IowaScaledEngineering/ckt-bd1/doc/ckt-bd1-bag-top.odt

Iowa Scaled Engineering, LLC

http://iascaled.com/

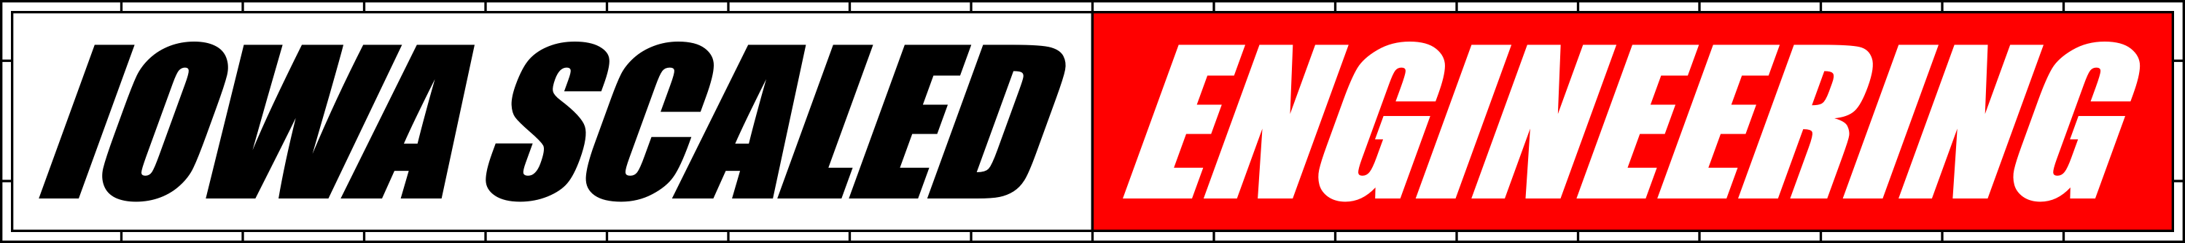
[picture p1: figure]

DCC Block Detector

The CKT-BD1 is a single-channel DCC block detector designed for high reliability and easy installation, providing two open collector outputs, adjustable sensitivity, and isolation between the track and signal systems.

CKT-BD1
