IowaScaledEngineering/ckt-bd1/pg/ckt-bd1-v4eval-v1.0-783c78a/ckt-bd1-v4eval-pcb.pdf

# ckt-bd1-v4eval.pcb

# 1. Table of Contents (This Page) Created on Sun Aug 15 19:28:39 2021

# 2. top 3. bottom 4. outline 5. plated-drill 6. componentmask 7. soldermask 8. topsilk 9. bottomsilk 10. toppaste 11. topassembly 12. bottomassembly 13. fab

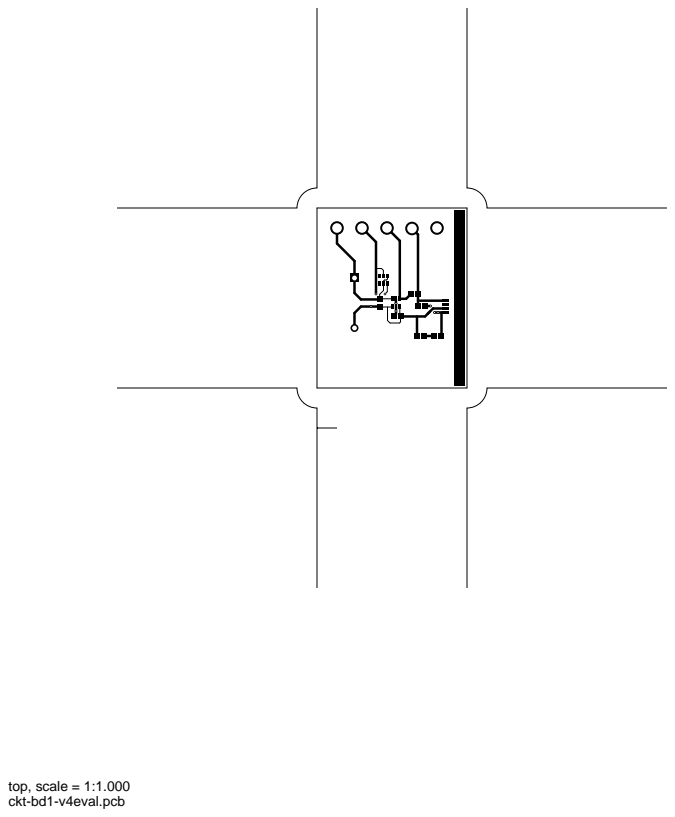
[picture p2: page 2]
top, scale = 1:1.000

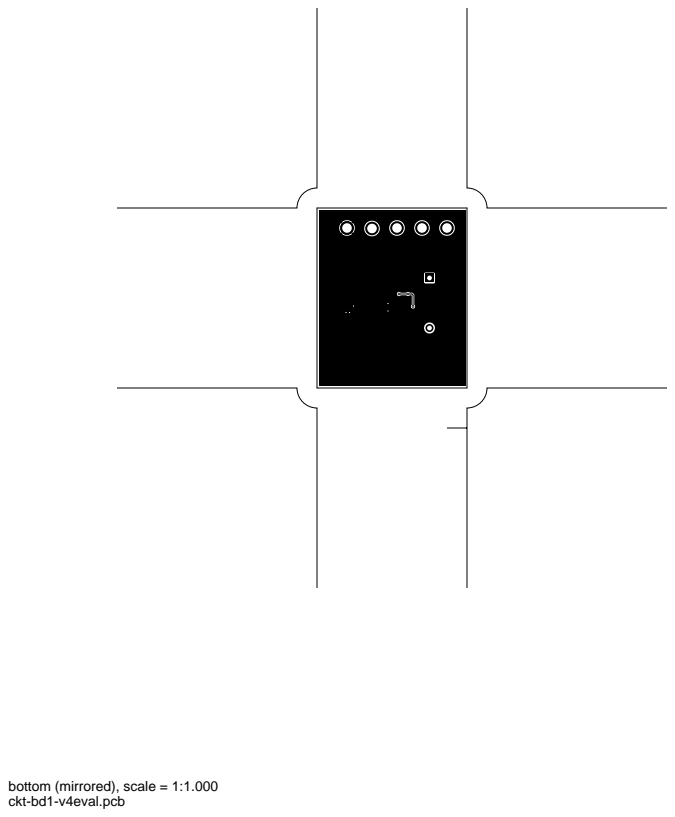
[picture p3: page 3]

bottom (mirrored), scale = 1:1.000

outline, scale = 1:1.000 plated-drill, scale = 1:1.000

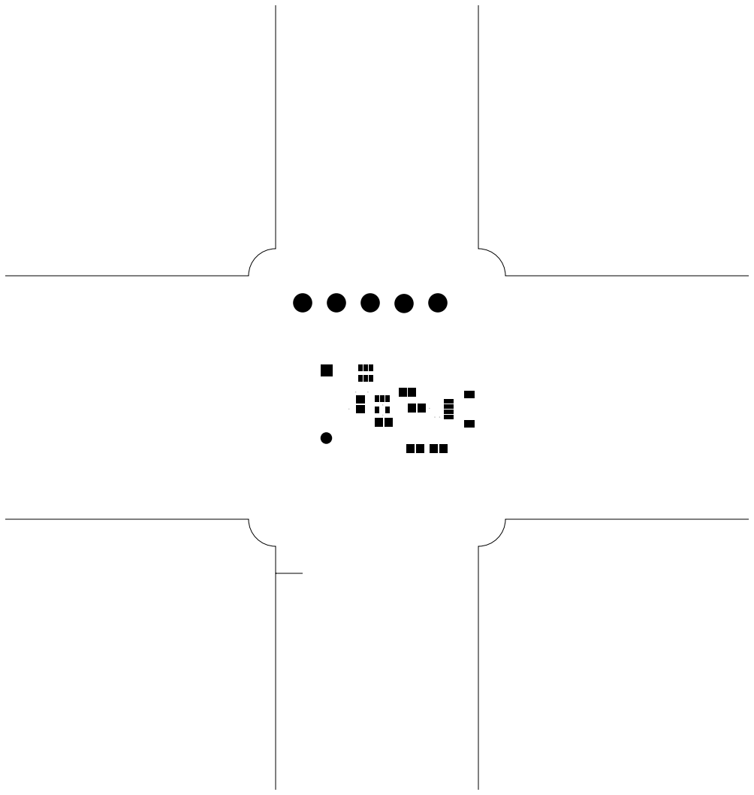
[picture p4: figure]

topmask, scale = 1:1.000

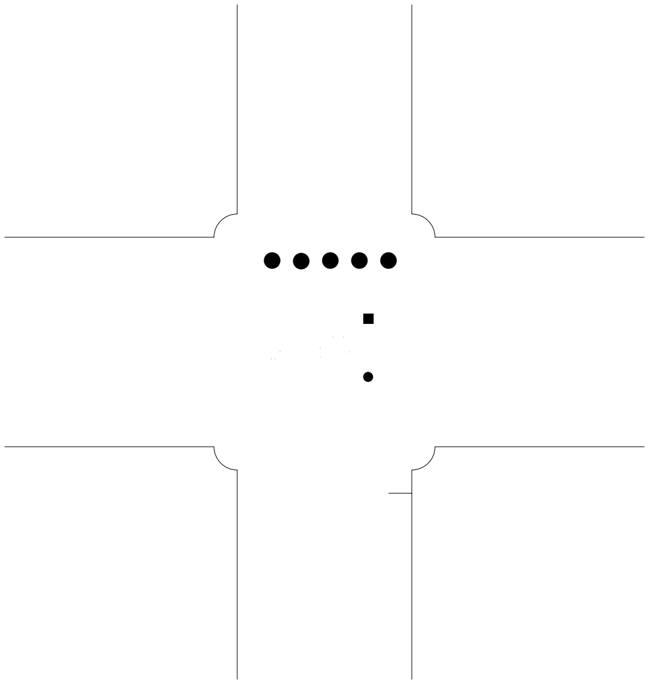
[picture p5: figure]

bottommask (mirrored), scale = 1:1.000

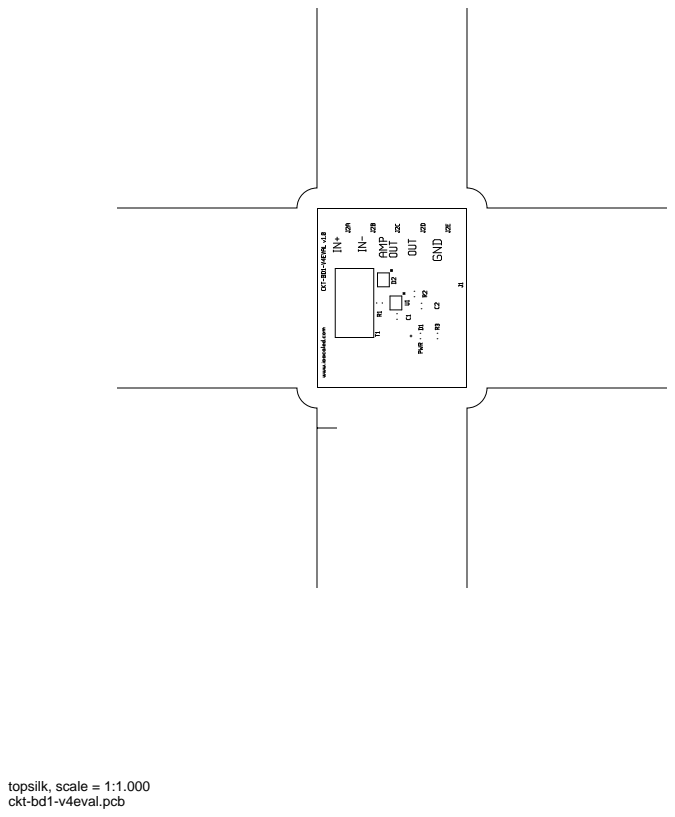
[picture p6: page 8]
topsilk, scale = 1:1.000

bottomsilk (mirrored), scale = 1:1.000

toppaste, scale = 1:1.000

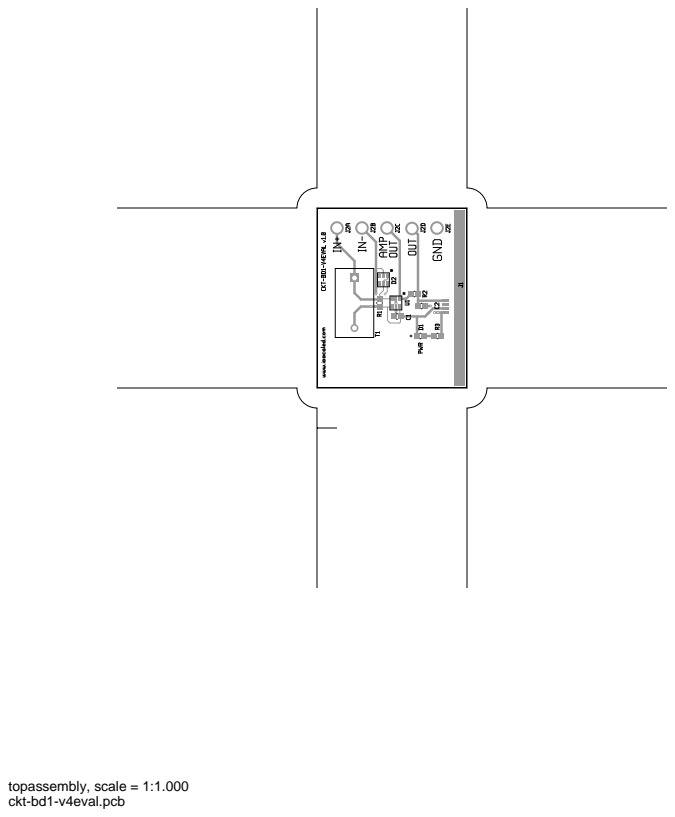
[picture p7: page 11]
topassembly, scale = 1:1.000

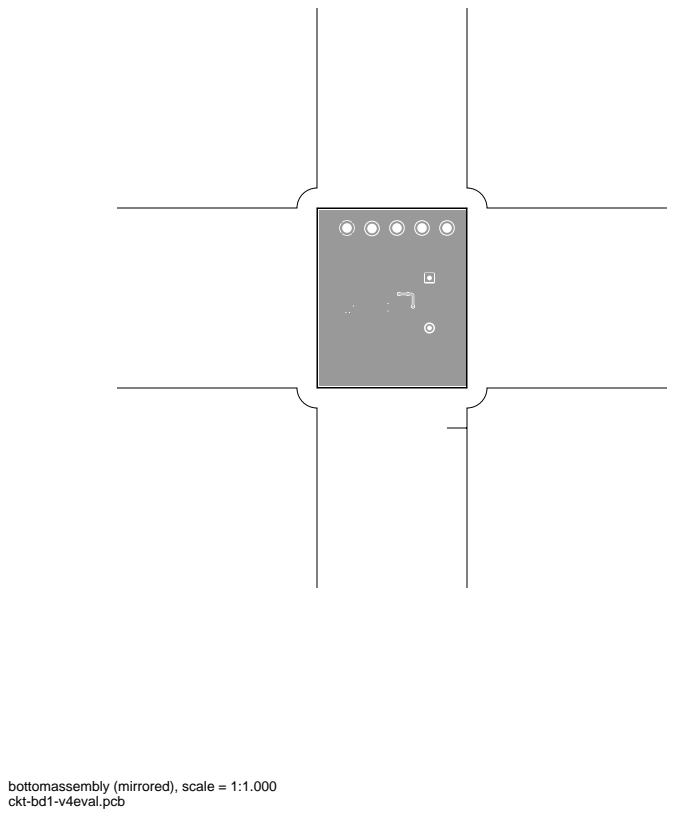
[picture p8: page 12]

bottomassembly (mirrored), scale = 1:1.000

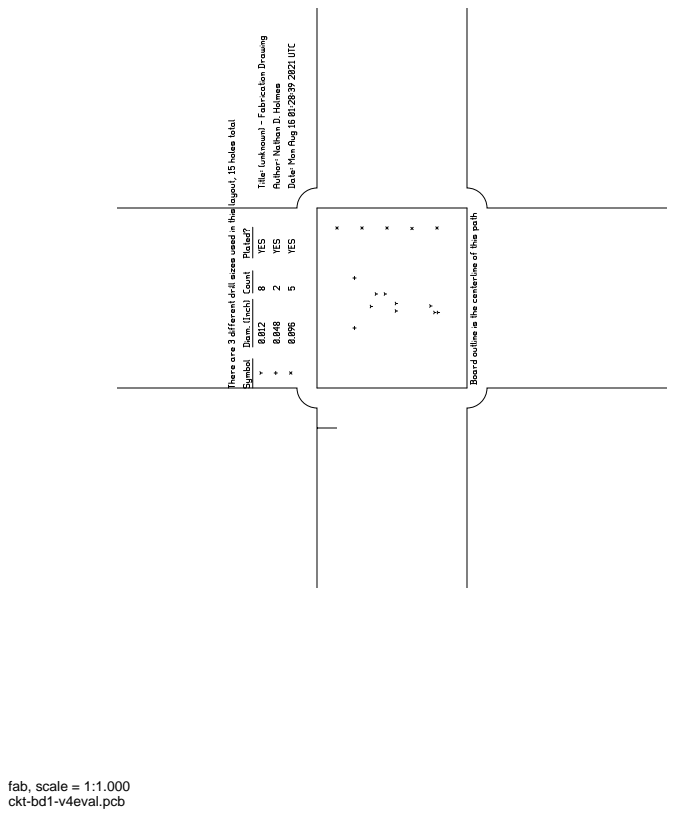
[picture p9: page 13]
fab, scale = 1:1.000
