IowaScaledEngineering/ckt-bd1/pg/ckt-bd1-cal-v1.0-e9a343d/ckt-bd1-cal-pcb.pdf

# ckt-bd1-cal.pcb

# 1. Table of Contents (This Page) Created on Thu Jul 2 14:46:42 2020

# 2. top 3. bottom 4. outline 5. bottommask 6. plated-drill 7. componentmask 8. soldermask 9. topsilk 10. bottomsilk 11. toppaste 12. topassembly 13. bottomassembly 14. fab

top, scale = 1:1.000

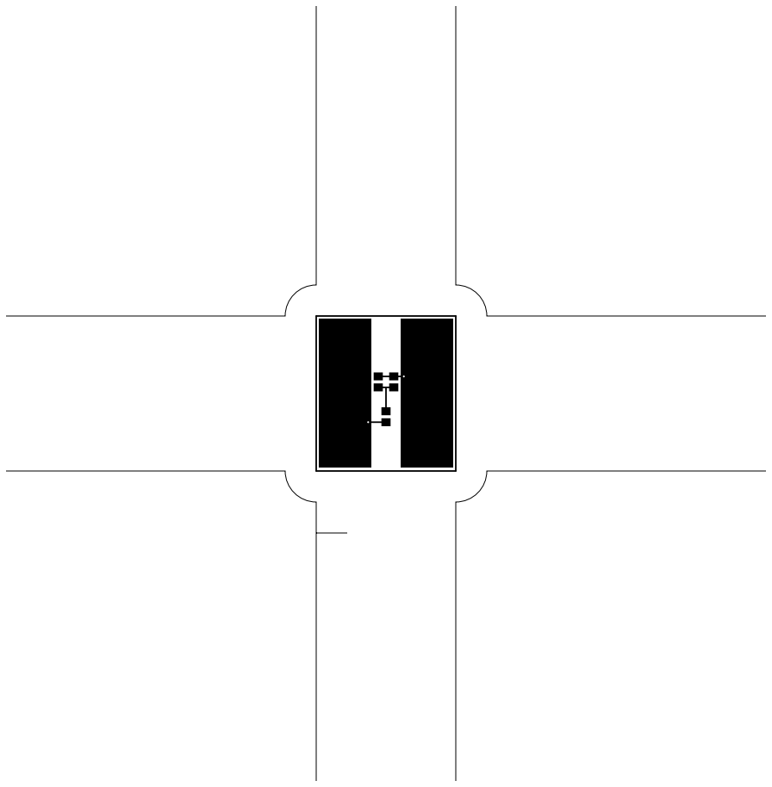
[picture p10: figure]

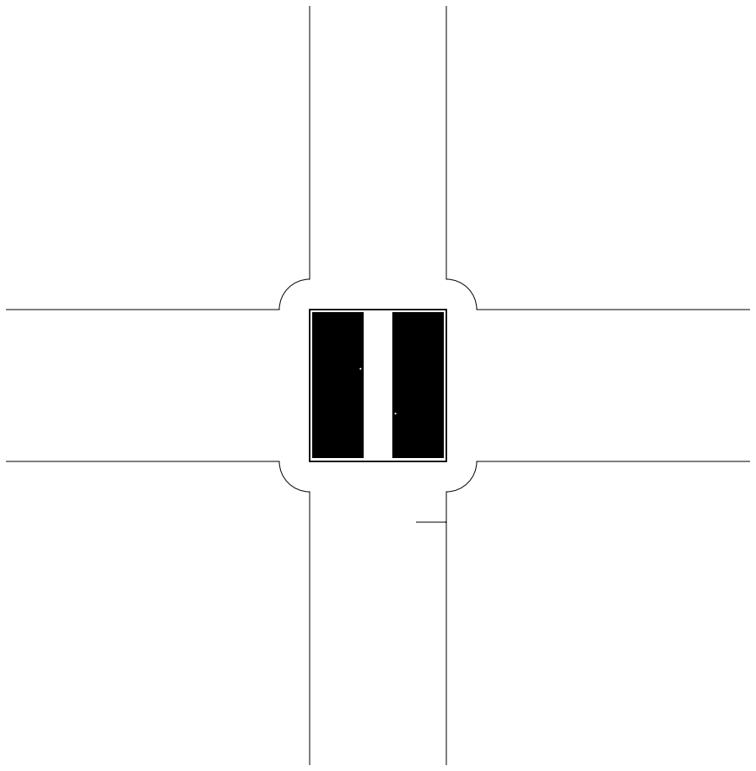
[picture p11: figure]

bottom (mirrored), scale = 1:1.000

outline, scale = 1:1.000

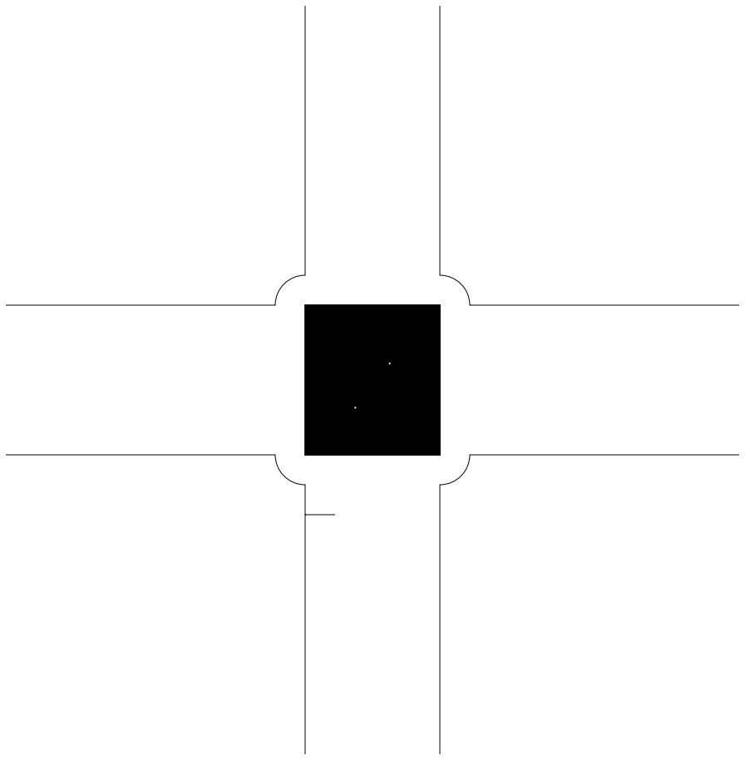
[picture p12: figure]

group3, scale = 1:1.000 plated-drill, scale = 1:1.000

topmask, scale = 1:1.000 bottommask (mirrored), scale = 1:1.000

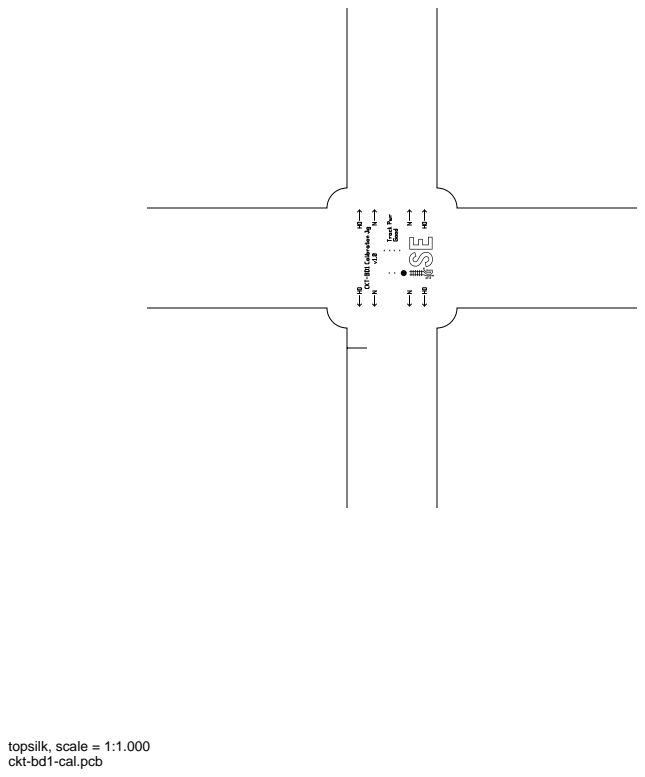
[picture p13: page 9]
topsilk, scale = 1:1.000

bottomsilk (mirrored), scale = 1:1.000

toppaste, scale = 1:1.000

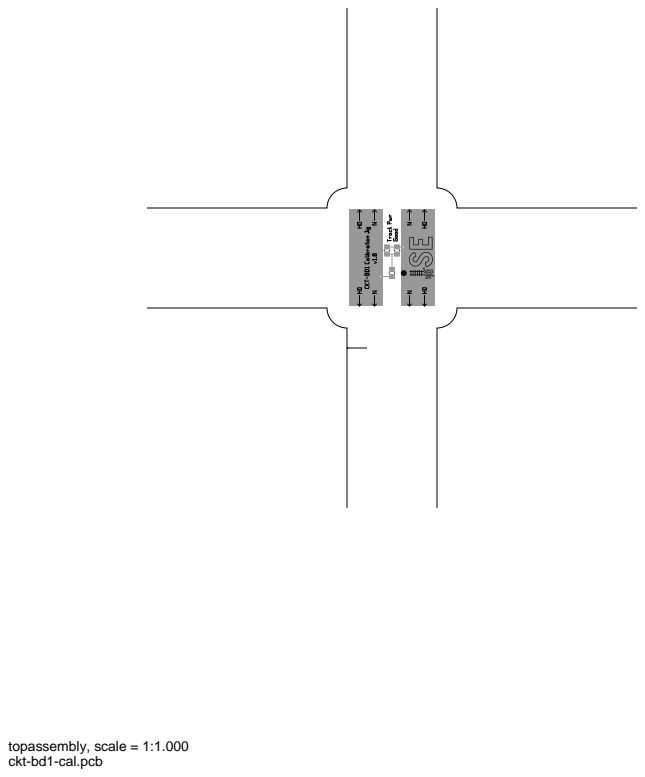
[picture p14: page 12]
topassembly, scale = 1:1.000

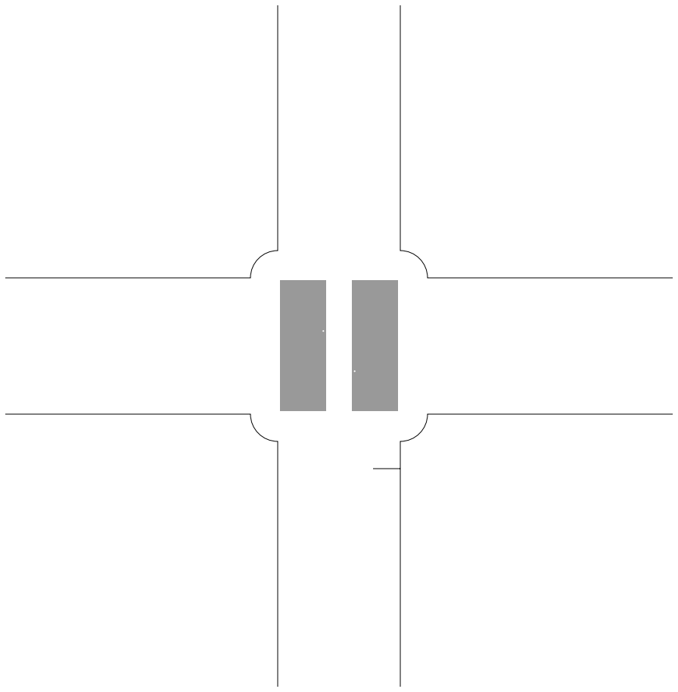
[picture p15: figure]

bottomassembly (mirrored), scale = 1:1.000

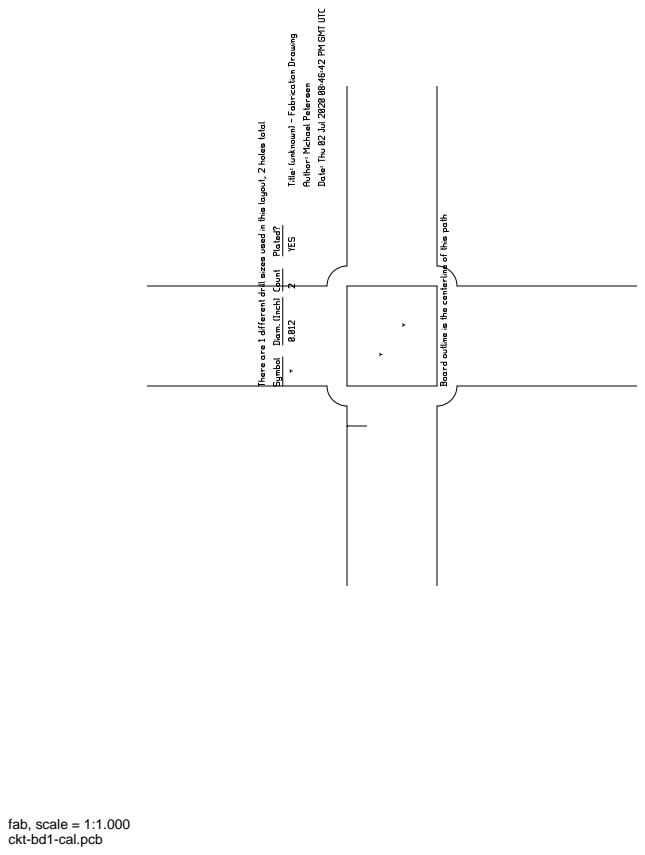
[picture p16: page 14]
fab, scale = 1:1.000
