IowaScaledEngineering/ckt-bd1/doc/ckt-bd1.png

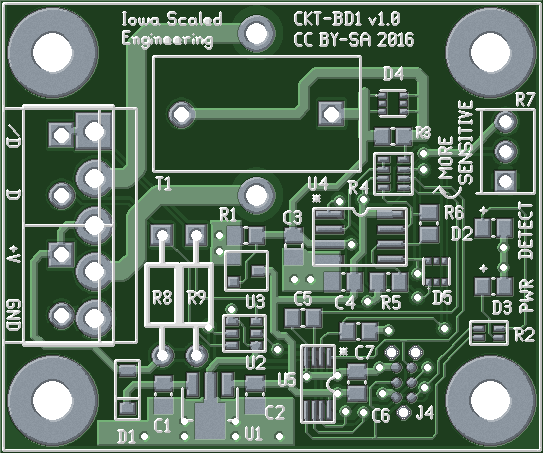
doc/ckt-bd1.png
