IowaScaledEngineering/ckt-bd1/mech/bd1-12x-blister-box v7.stl

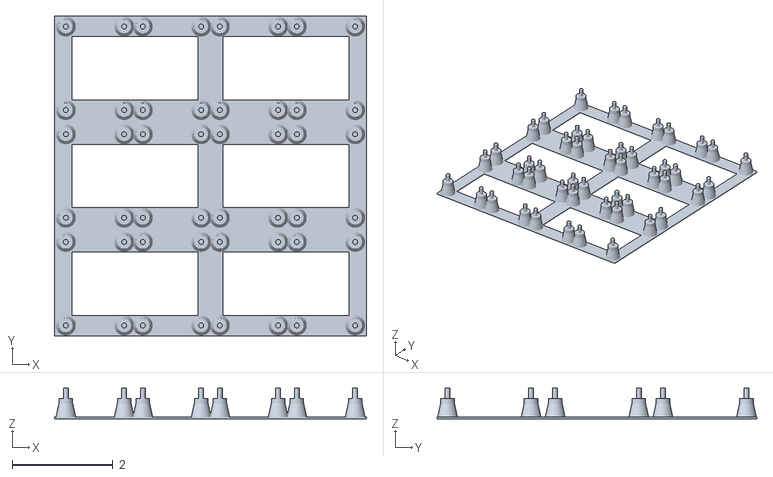
[picture p18: CAD file, 2023-02-24]
mech/bd1-12x-blister-box v7.stl
6.20 x 6.35 x 0.606
