IowaScaledEngineering/ckt-bd1/mech/bd1-6x-blister-box v5.stl

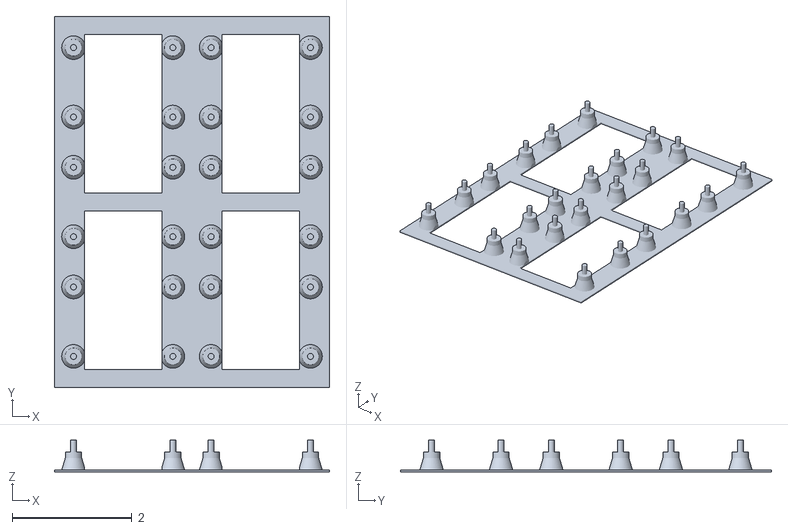
[picture p19: CAD file, 2023-02-24]
mech/bd1-6x-blister-box v5.stl
4.60 x 6.20 x 0.531
