IowaScaledEngineering/ckt-bd1/mech/bd1-blister-box v5.stl

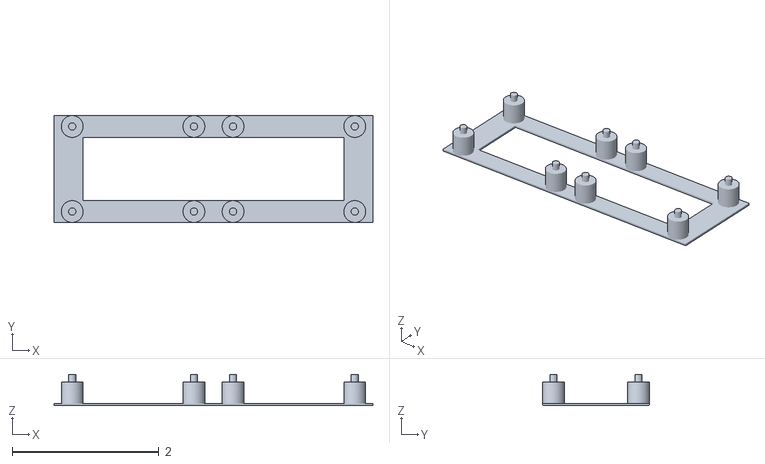
[picture p20: CAD file, 2022-12-14]
mech/bd1-blister-box v5.stl
4.35 x 1.46 x 0.425
