IowaScaledEngineering/ckt-bd1/doc/usermanual/render.png

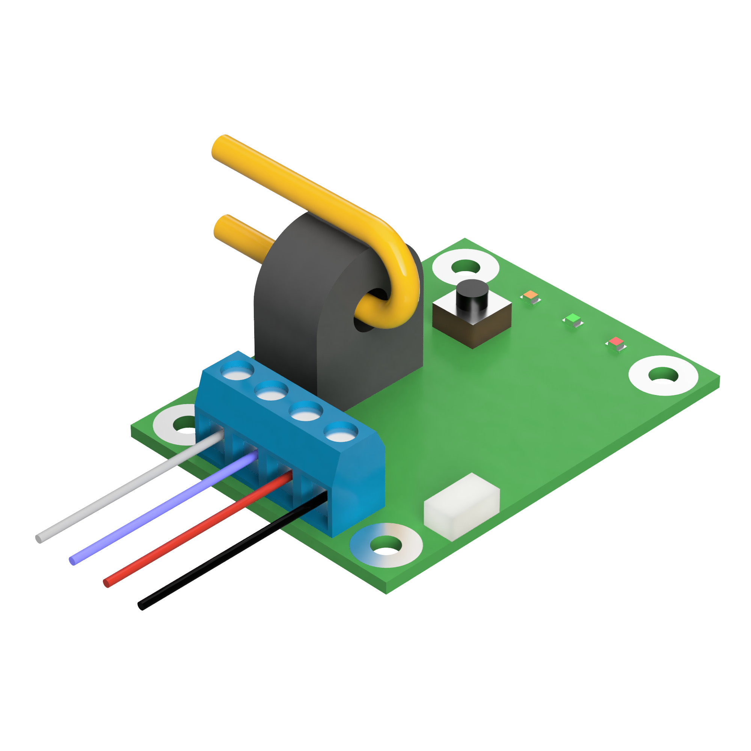
doc/usermanual/render.png
