IowaScaledEngineering/ckt-bd1/doc/gain-analysis-testboards.ods

mA | ADC
1 | 10
2 | 45
3 | 131
4 | 274
5 | 380
6 | 498
7 | 629
8 | 686
9
10
mA | BD0 | BD1 | BD2 | mA | Avg | Change
0 | 0 | 0 | 0 | 0 | 0
0.484 | 196 | 334 | 381 | 0.484 | 304 | 304
0.93 | 706 | 798 | 836 | 0.93 | 780 | 476
1.57 | 2000 | 2010 | 2160 | 1.57 | 2057 | 1277
1.98 | 3025 | 2970 | 3150 | 1.98 | 3048 | 992
2.52 | 4530 | 4170 | 4500 | 2.52 | 4400 | 1352
3.03 | 6180 | 5580 | 5860 | 3.03 | 5873 | 1473
3.56 | 7927 | 7300 | 7375 | 3.56 | 7534 | 1661
3.99 | 9485 | 9070 | 8700 | 3.99 | 9085 | 1551
4.47 | 11225 | 10800 | 10747 | 4.47 | 10924 | 1839
4.95 | 12700 | 12700 | 12460 | 4.95 | 12620 | 1696
5.09 | 13520 | 13400 | 13250 | 5.09 | 13390 | 770
5.53 | 14900 | 14900 | 15025 | 5.53 | 14942 | 1552
6.05 | 16560 | 16780 | 16800 | 6.05 | 16713 | 1772
6.5 | 17625 | 18100 | 18300 | 6.5 | 18008 | 1295
7.02 | 19020 | 19550 | 19950 | 7.02 | 19507 | 1498
7.56 | 20250 | 20860 | 21250 | 7.56 | 20787 | 1280
7.98 | 21200 | 21775 | 22150 | 7.98 | 21708 | 922
8.44 | 22200 | 22700 | 23025 | 8.44 | 22642 | 933
9.02 | 23275 | 23500 | 23900 | 9.02 | 23558 | 917
9.55 | 24275 | 24250 | 24650 | 9.55 | 24392 | 833
9.98 | 25050 | 24750 | 25200 | 9.98 | 25000 | 608
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
