IowaScaledEngineering/ckt-bd1/pg/bd-tester-v1.0-8676916/bd-tester.pdf

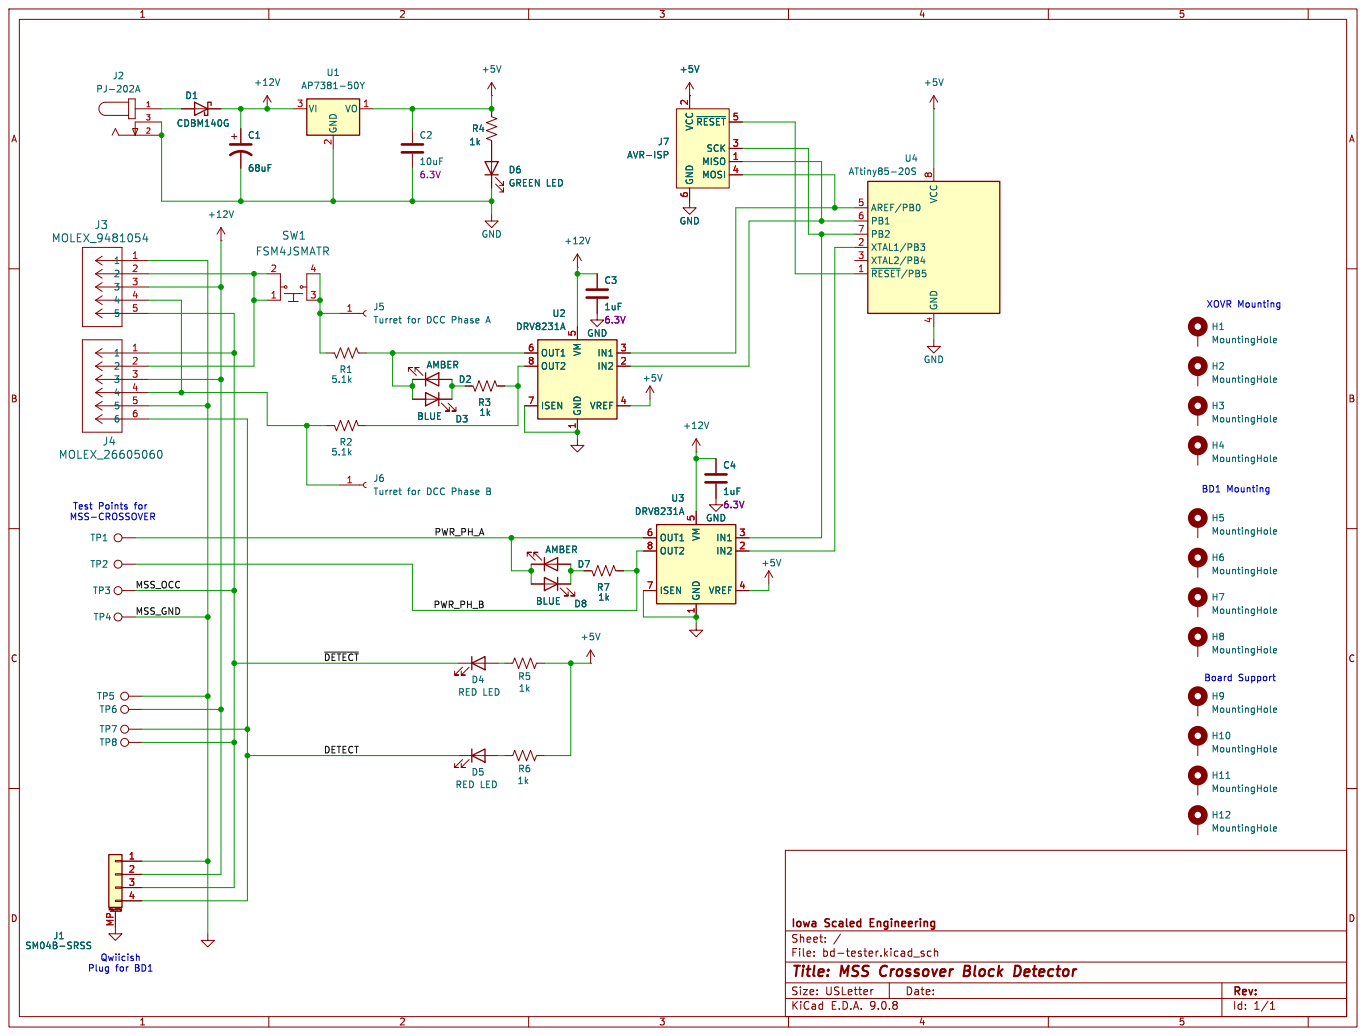
[picture p28: page 1]

6 ~{RESET}5 SCK 3 MISO 1 MOSI 4 +5V C4

6 ~{RESET}5 SCK 3 MISO 1 MOSI 4

BD1 Mounting XOVR Mounting Board Support Test Points for MSS-CROSSOVER

DETECT Qwiicish Plug for BD1

Id: 1/1 Title: MSS Crossover Block Detector File: bd-tester.kicad_sch Sheet: /
