IowaScaledEngineering/ckt-bd1/pg/ckt-bd1-tester-v4.0A-9b8d3c5/ckt-bd1-tester-pcb.pdf

# ckt-bd1-tester.pcb

# 1. Table of Contents (This Page) Created on Sun Nov 21 21:13:10 2021

# 2. top 3. bottom 4. outline 5. plated-drill 6. unplated-drill 7. componentmask 8. soldermask 9. topsilk 10. bottomsilk 11. toppaste 12. topassembly 13. bottomassembly 14. fab

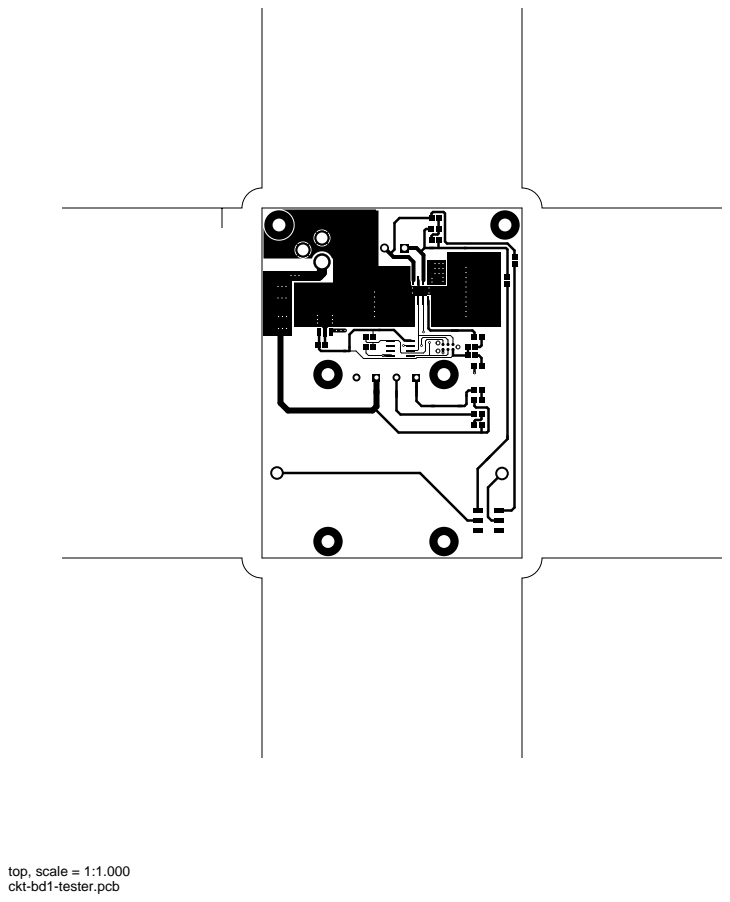
[picture p29: page 2]
top, scale = 1:1.000

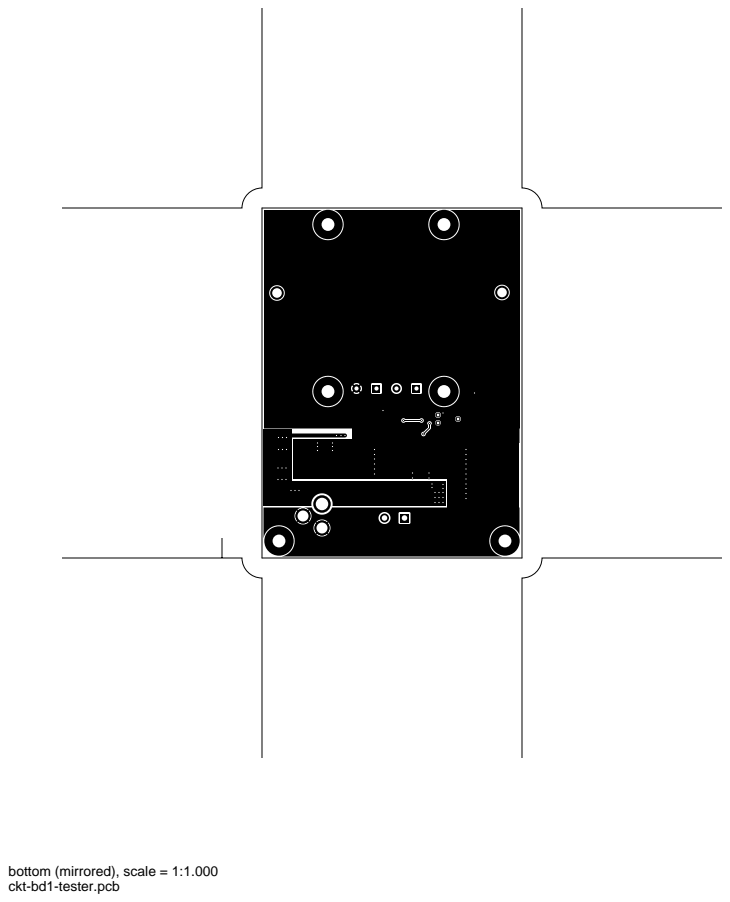
[picture p30: page 3]

bottom (mirrored), scale = 1:1.000

outline, scale = 1:1.000

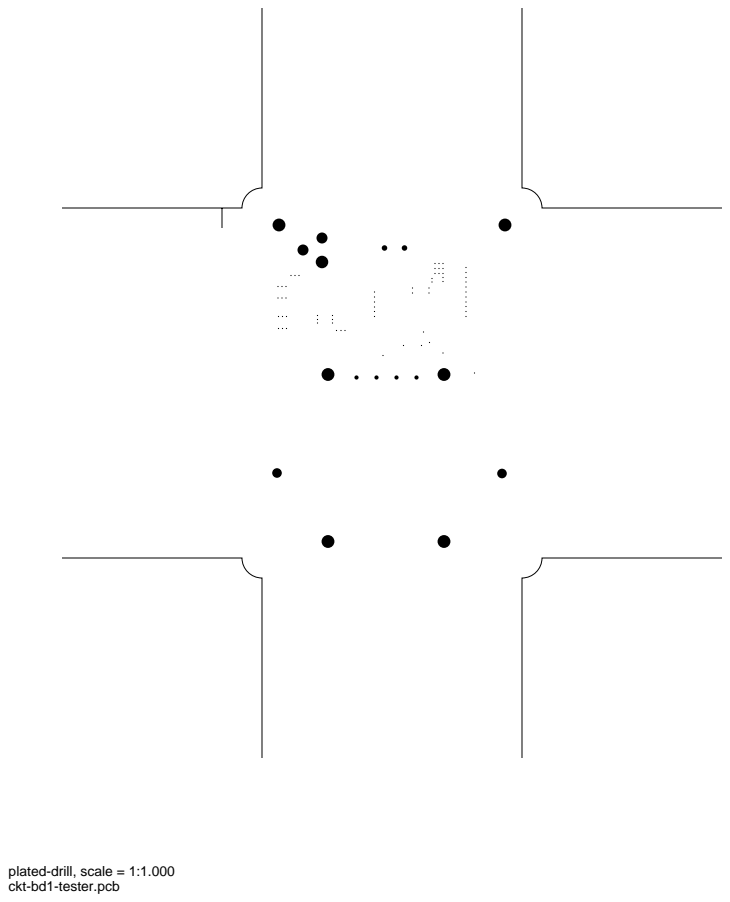
[picture p31: page 5]

plated-drill, scale = 1:1.000

unplated-drill, scale = 1:1.000

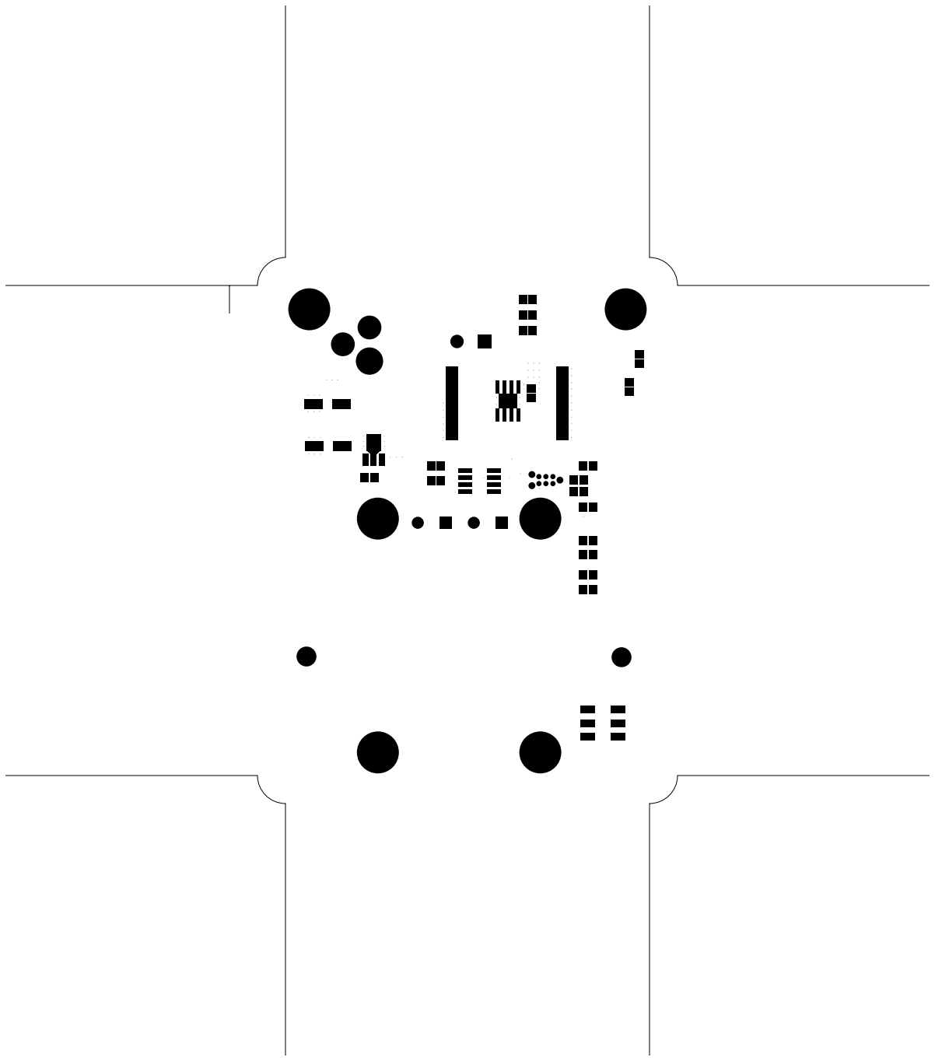
[picture p32: figure]

topmask, scale = 1:1.000

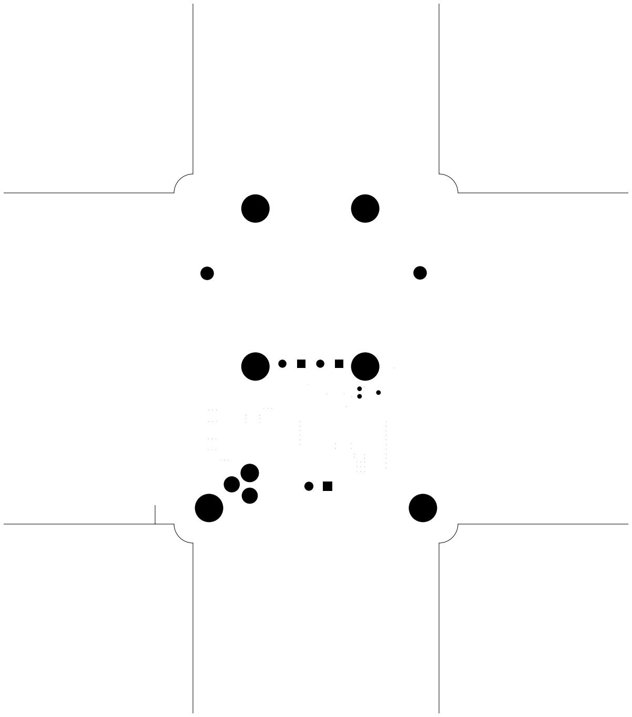
[picture p33: figure]

bottommask (mirrored), scale = 1:1.000

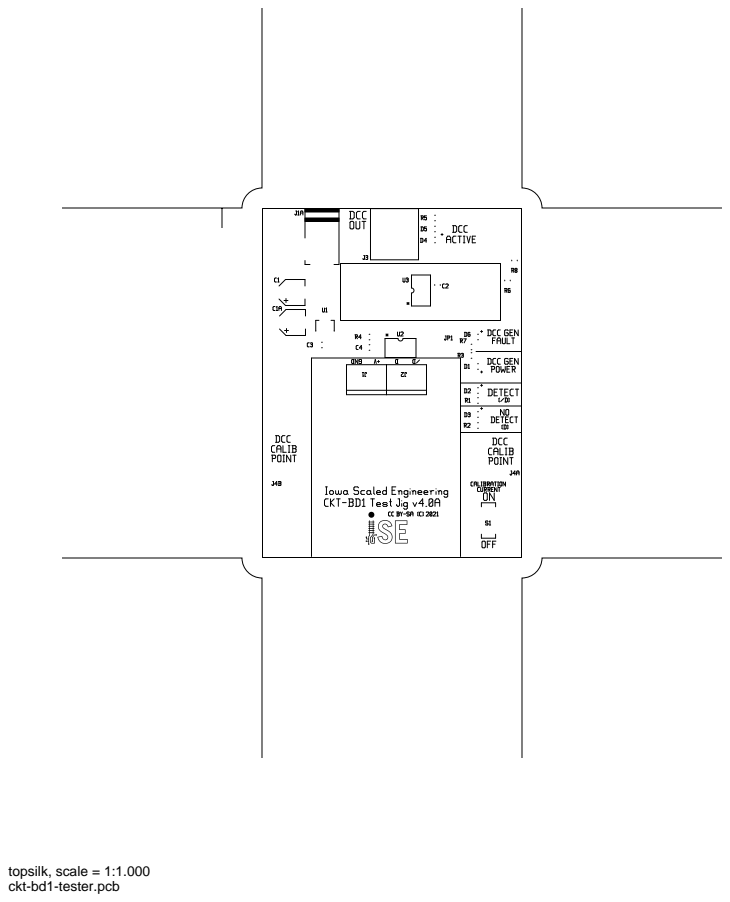
[picture p34: page 9]
topsilk, scale = 1:1.000

bottomsilk (mirrored), scale = 1:1.000

toppaste, scale = 1:1.000

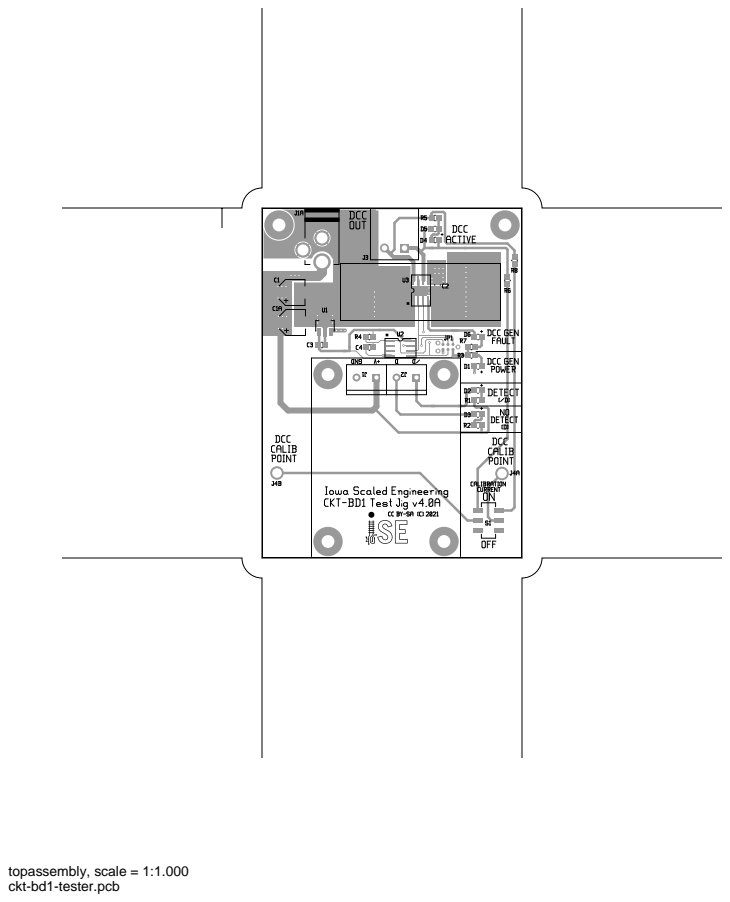
[picture p35: page 12]
topassembly, scale = 1:1.000

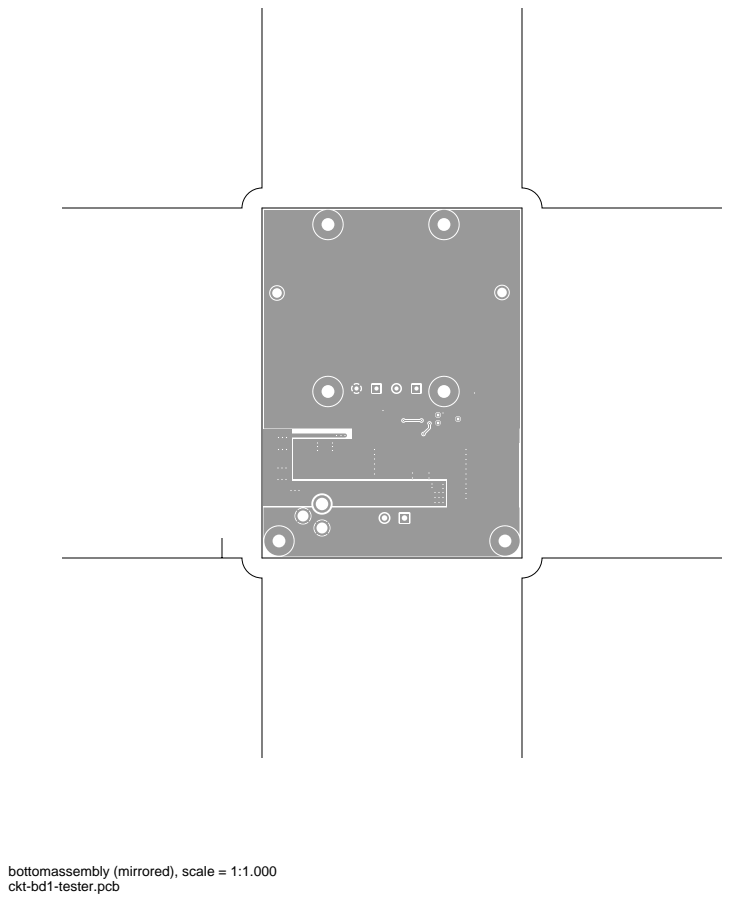
[picture p36: page 13]

bottomassembly (mirrored), scale = 1:1.000

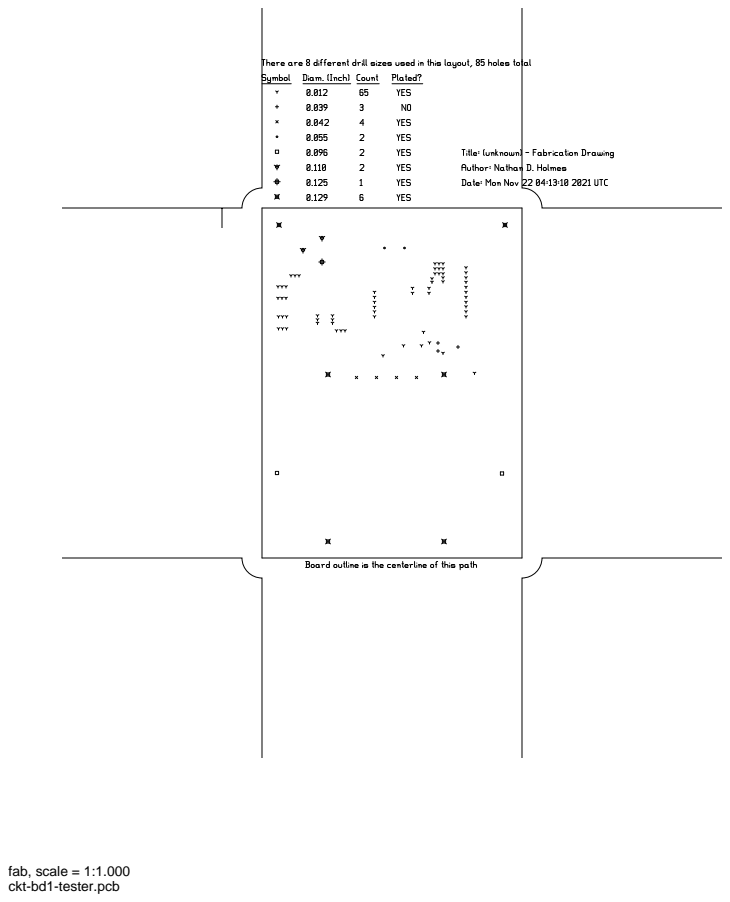
[picture p37: page 14]
fab, scale = 1:1.000
