IowaScaledEngineering/ckt-bd1/pg/ckt-bd1-tester-v4.0A-9b8d3c5/ckt-bd1-tester.pdf

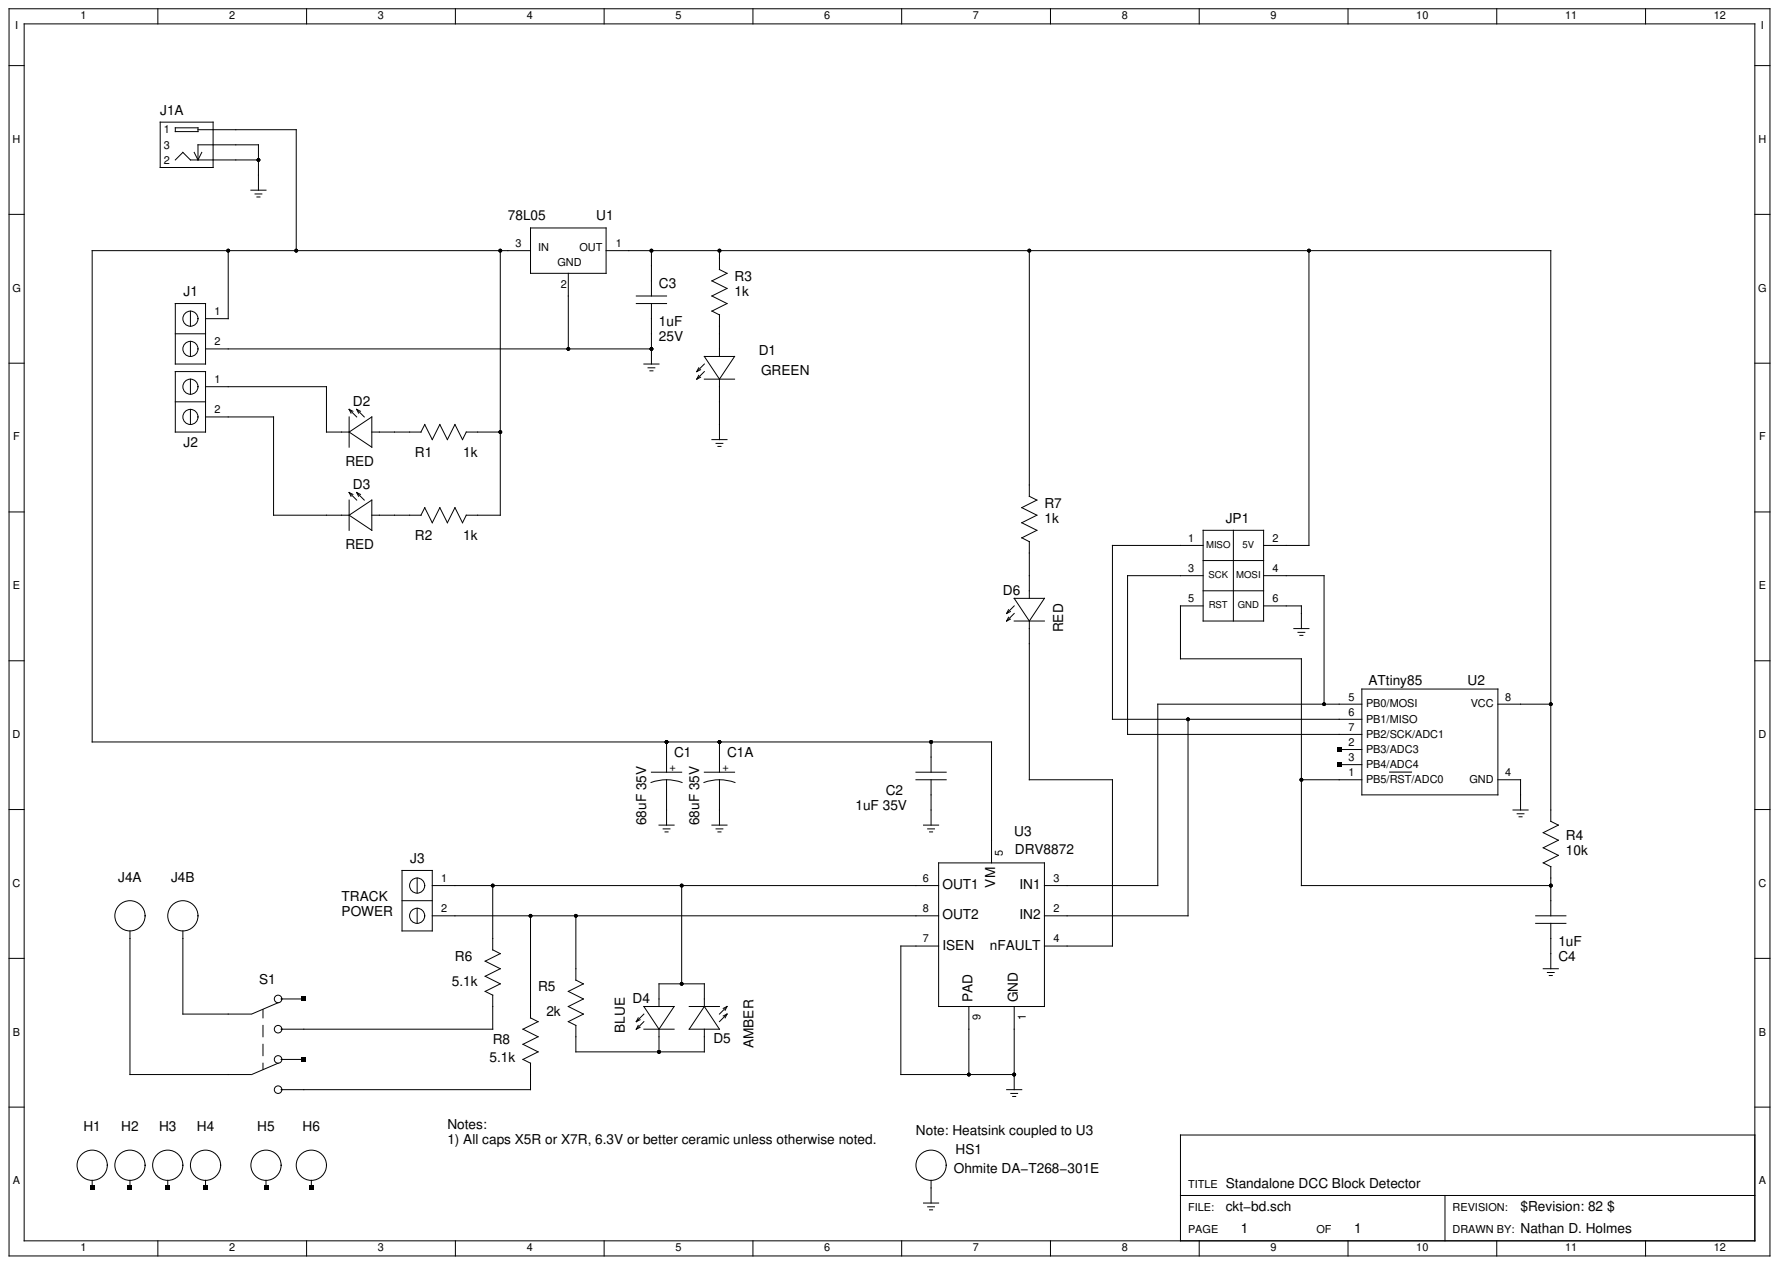
[picture p38: page 1]

Notes:
1) All caps X5R or X7R, 6.3V or better ceramic unless otherwise noted.

Note: Heatsink coupled to U3
Ohmite DA−T268−301E

Standalone DCC Block Detector
ckt−bd.sch
