IowaScaledEngineering/ckt-bd1/pg/ckt-bd1-array-v4.1-e7e0b8d/ckt-bd1.pdf

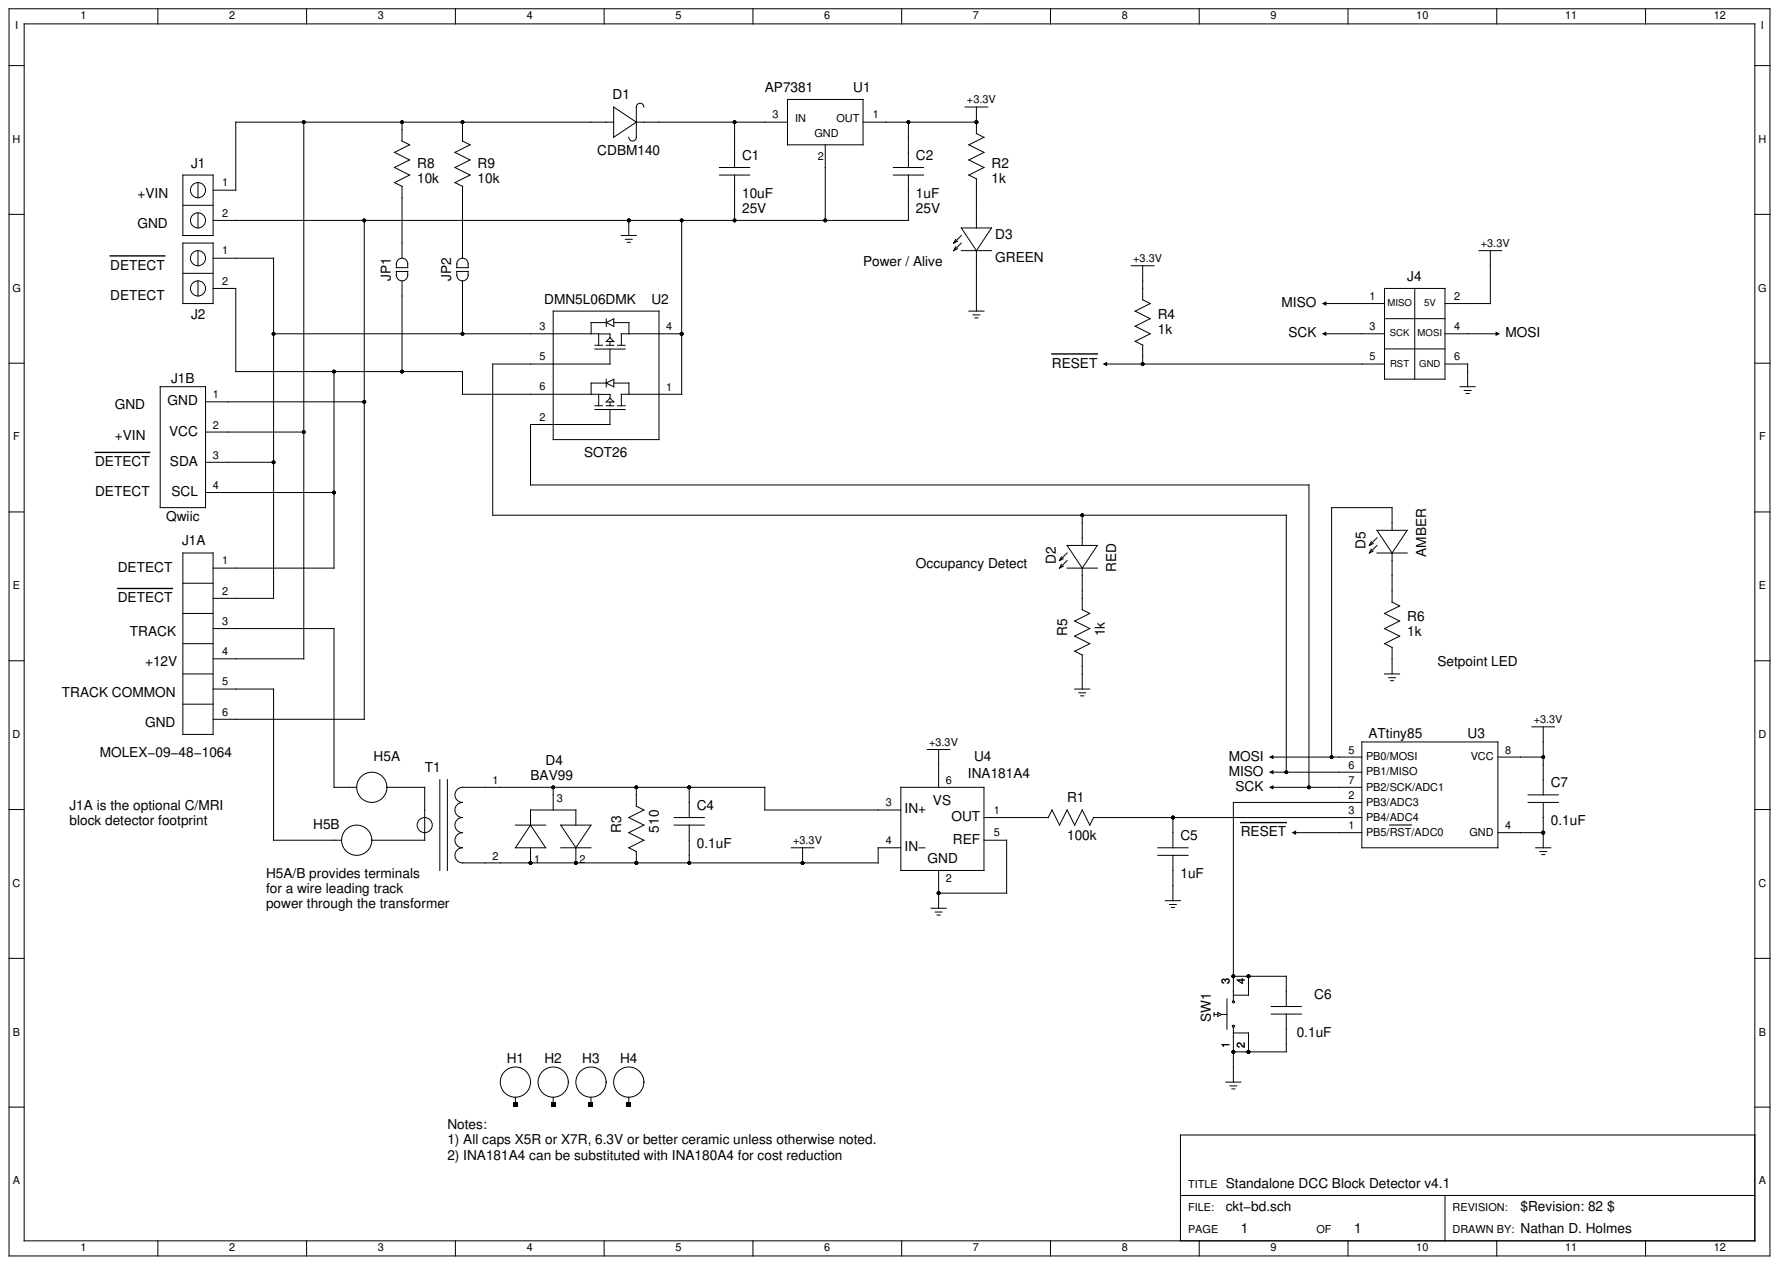
[picture p39: page 1]

J1A is the optional C/MRI
block detector footprint

H5A/B provides terminals
for a wire leading track
power through the transformer

Notes:
1) All caps X5R or X7R, 6.3V or better ceramic unless otherwise noted.
2) INA181A4 can be substituted with INA180A4 for cost reduction

Standalone DCC Block Detector v4.1
ckt−bd.sch
