IowaScaledEngineering/ckt-bd1/pg/ckt-bd1-v4.0A-0376af4/ckt-bd1.pdf

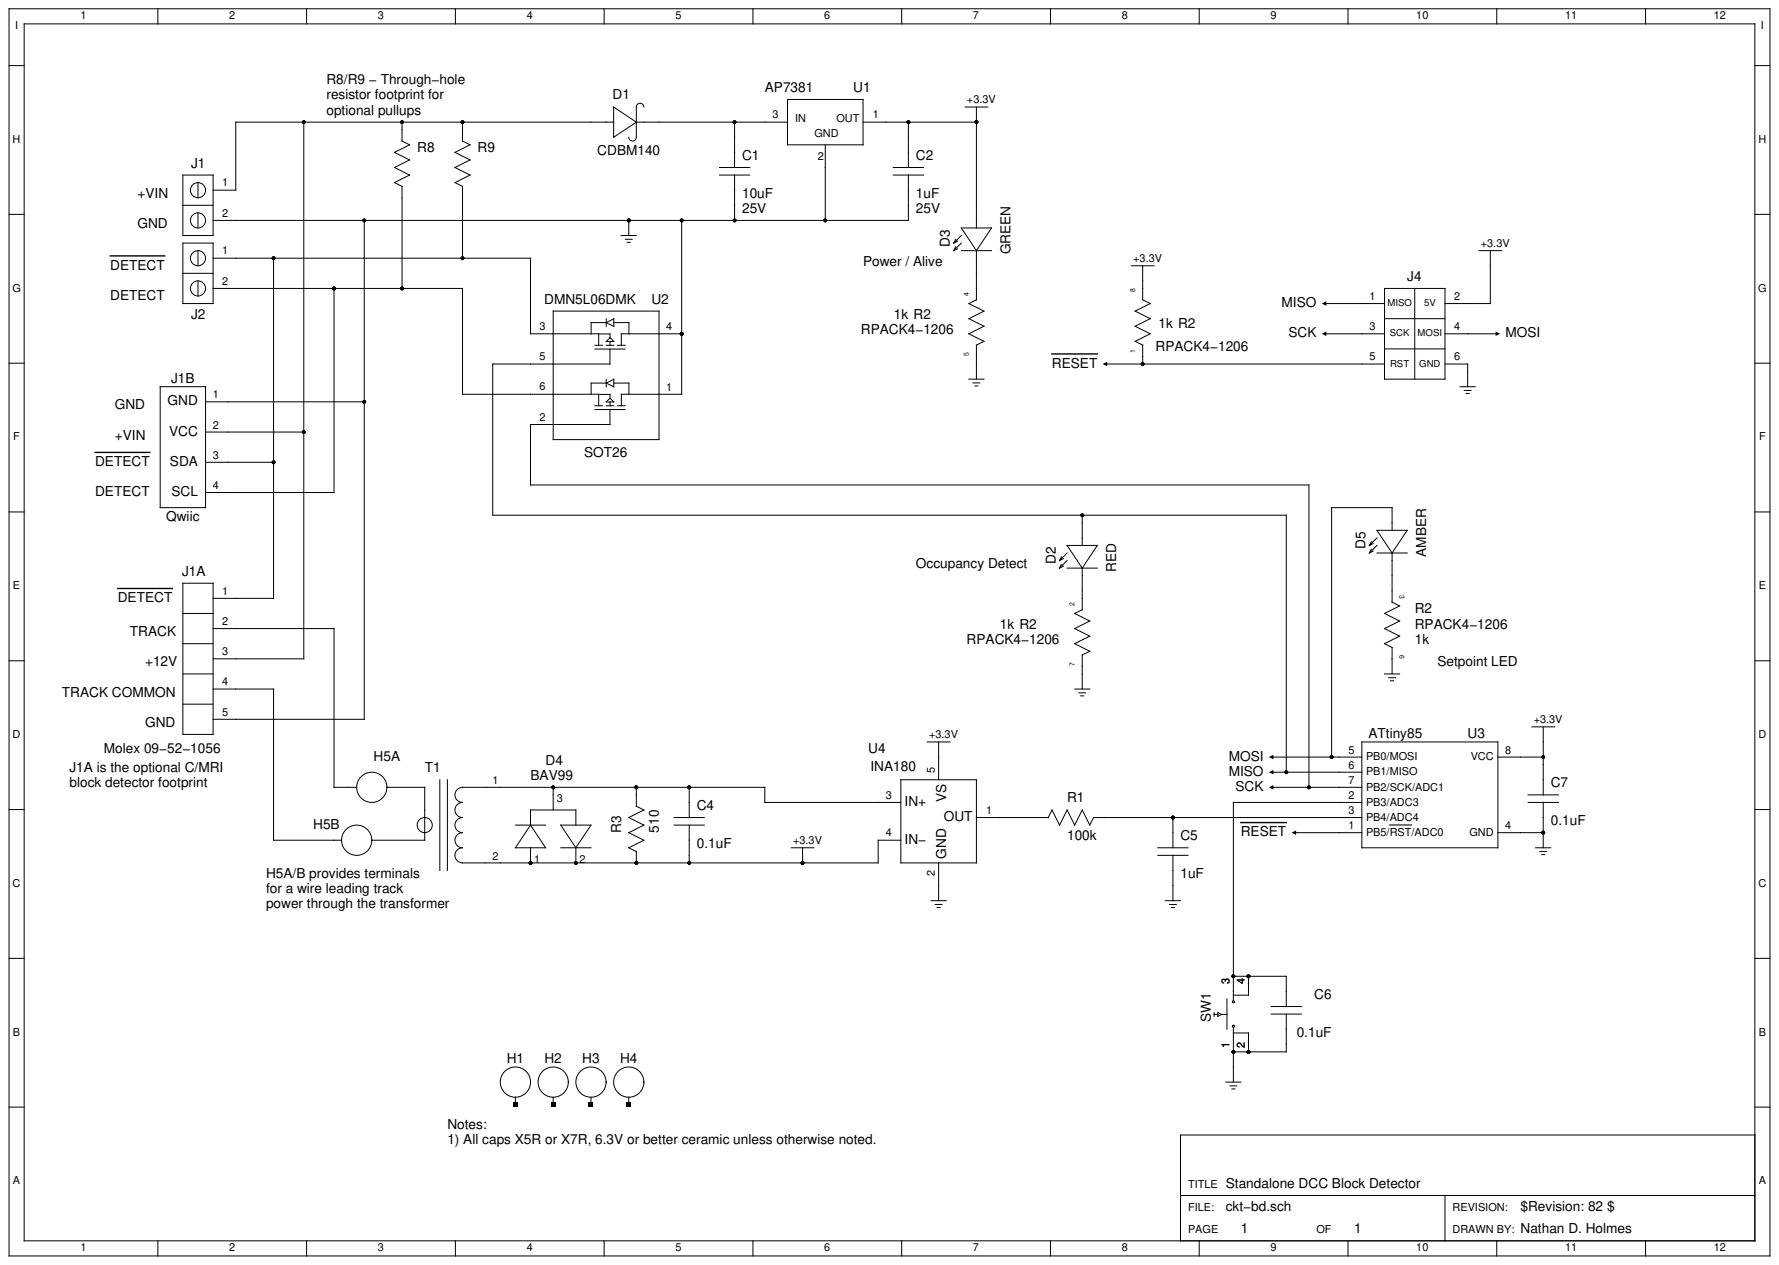
[picture p61: page 1]

MISO | 5V

Molex 09−52−1056
J1A is the optional C/MRI
block detector footprint

H5A/B provides terminals
for a wire leading track
power through the transformer

Notes:
1) All caps X5R or X7R, 6.3V or better ceramic unless otherwise noted.

Standalone DCC Block Detector
ckt−bd.sch
