IowaScaledEngineering/ckt-bd1/pg/ckt-bd1-v4eval-v1.0-783c78a/ckt-bd1-v4eval.pdf

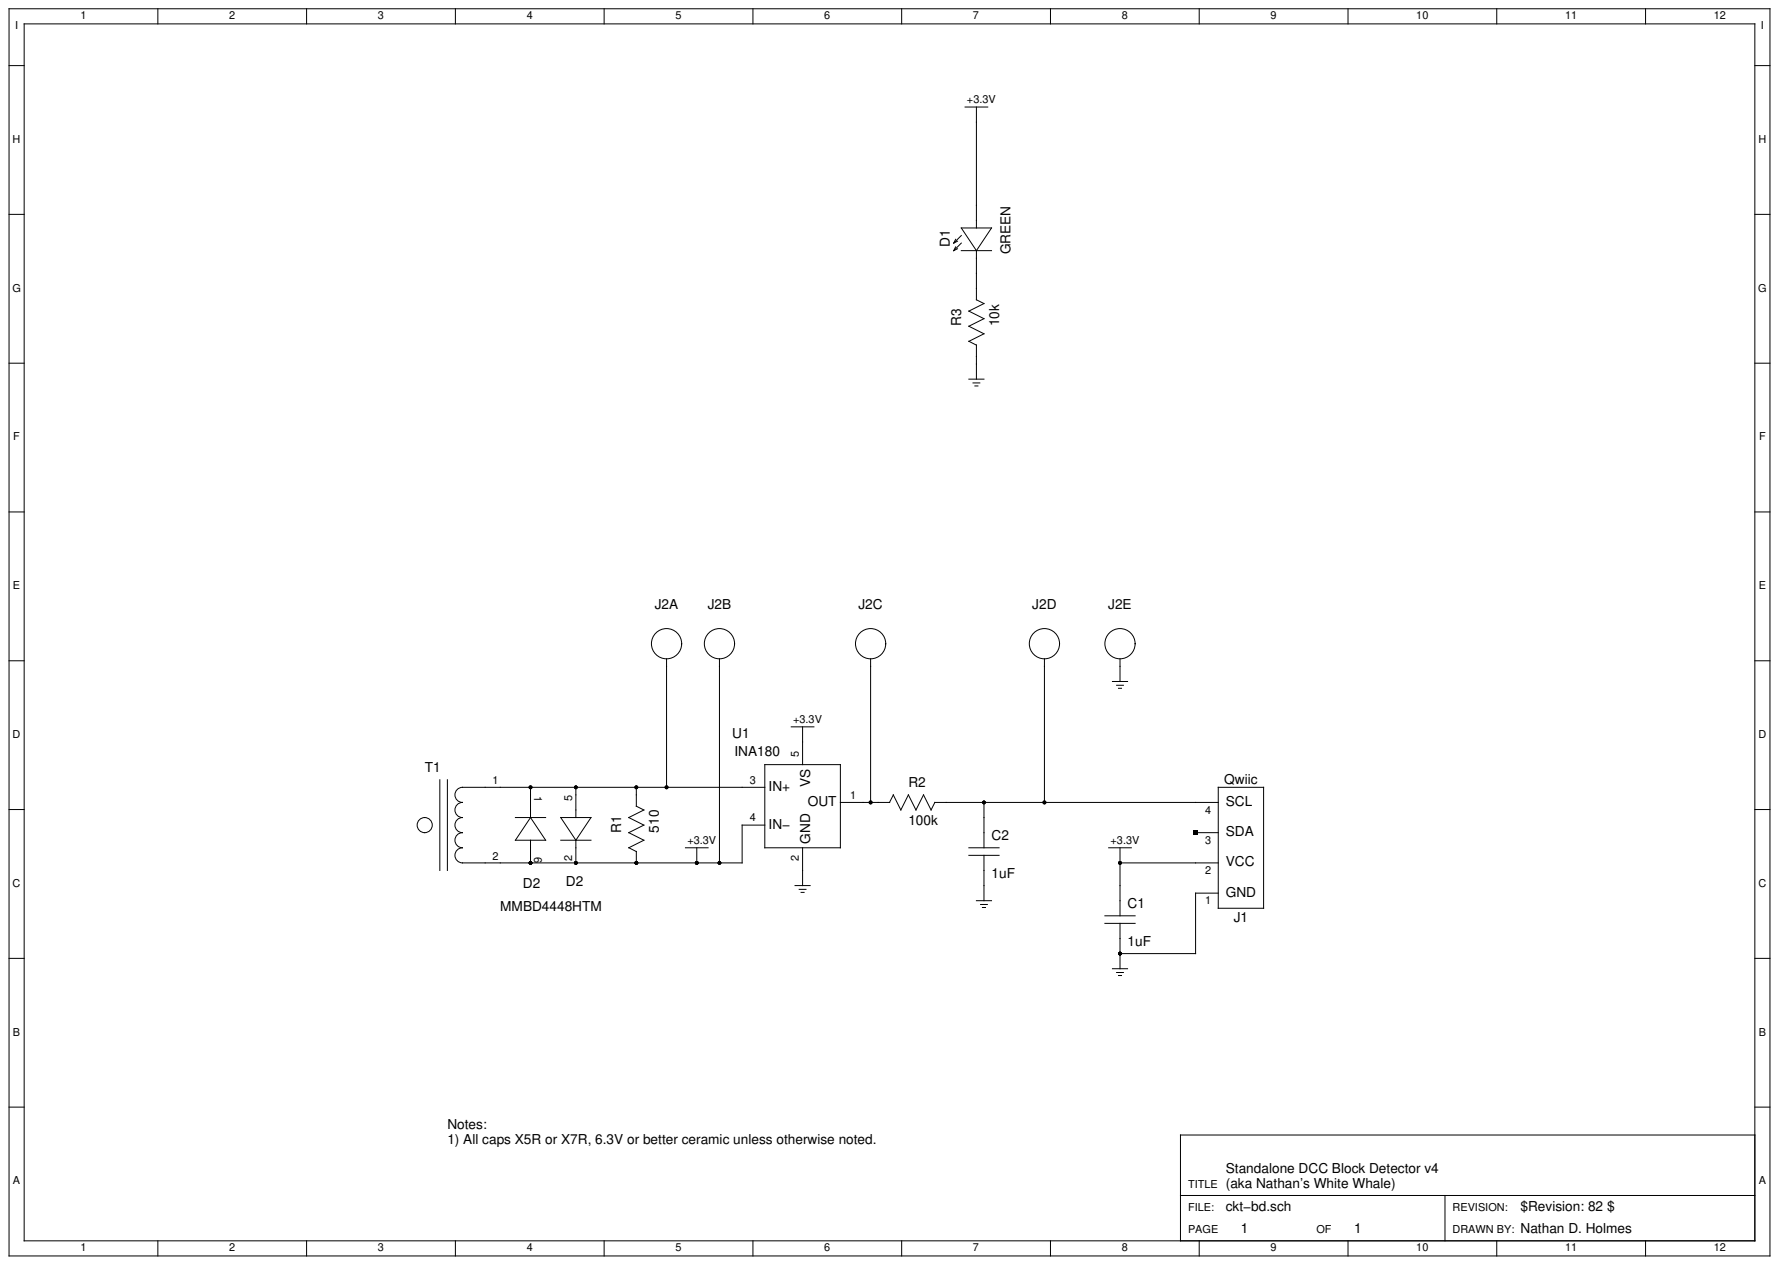
[picture p62: page 1]

Notes:
1) All caps X5R or X7R, 6.3V or better ceramic unless otherwise noted.

Standalone DCC Block Detector v4
(aka Nathan’s White Whale)
ckt−bd.sch
