IowaScaledEngineering/ckt-bd1/pg/ckt-bd1-tester-v1.0-c19359c/ckt-bd1-tester-pcb.pdf

# ckt-bd1-tester.pcb

# 1. Table of Contents (This Page) Created on Mon Feb 22 11:13:24 2021

# 2. top 3. bottom 4. outline 5. plated-drill 6. unplated-drill 7. componentmask 8. soldermask 9. topsilk 10. bottomsilk 11. toppaste 12. topassembly 13. bottomassembly 14. fab

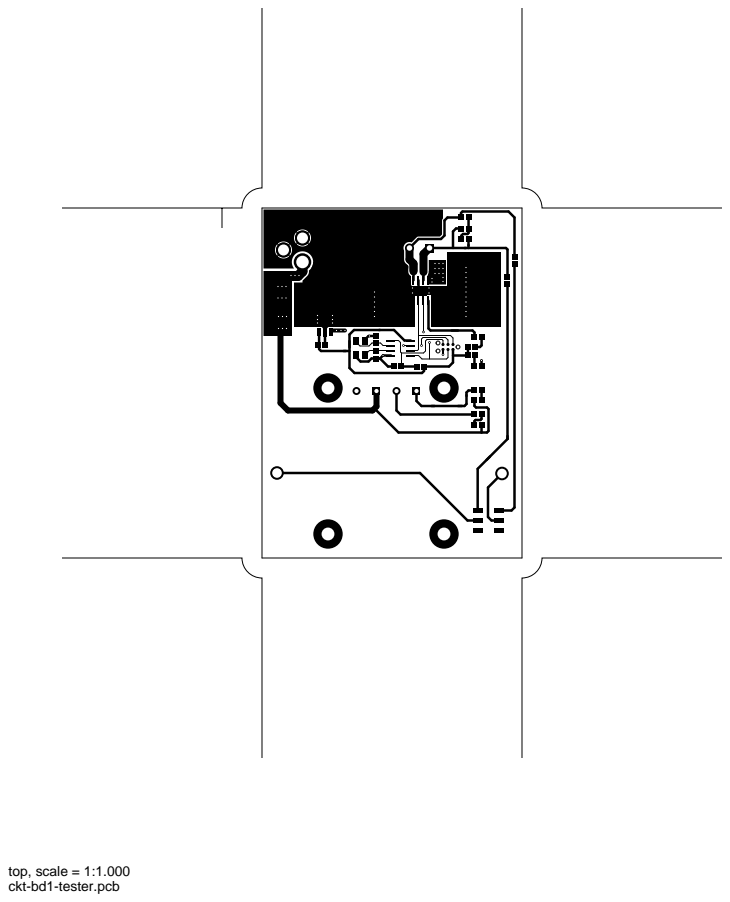
[picture p63: page 2]
top, scale = 1:1.000

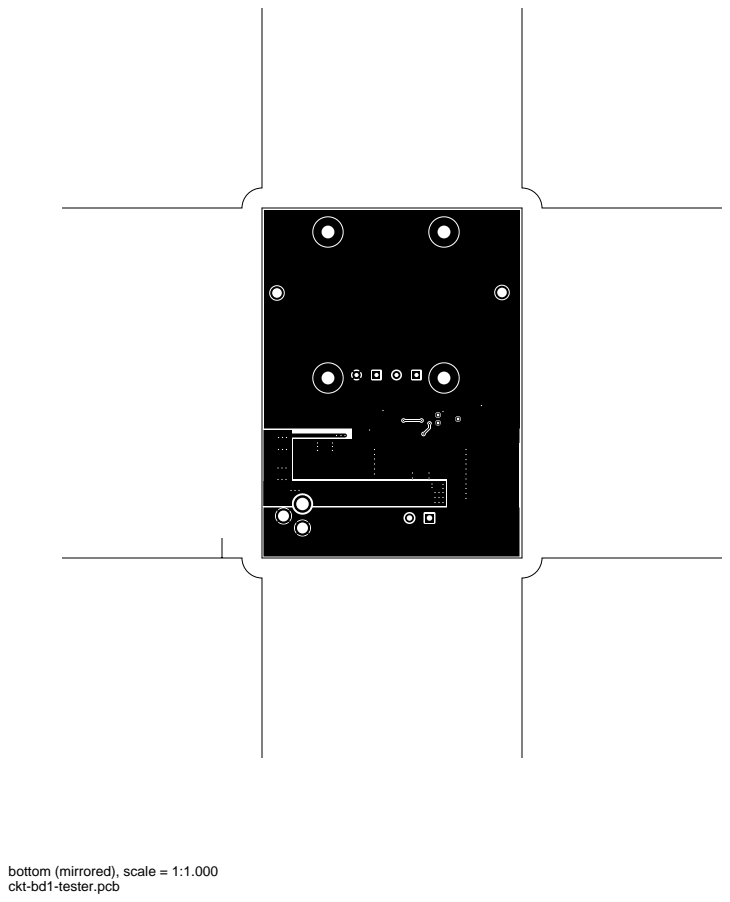
[picture p64: page 3]

bottom (mirrored), scale = 1:1.000

outline, scale = 1:1.000

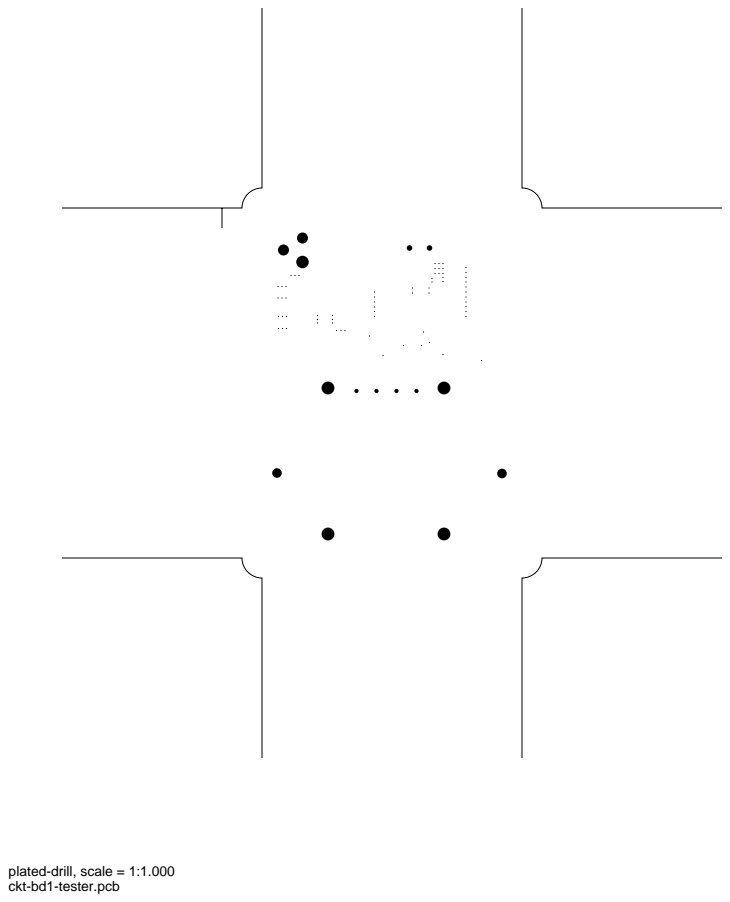
[picture p65: page 5]

plated-drill, scale = 1:1.000

unplated-drill, scale = 1:1.000

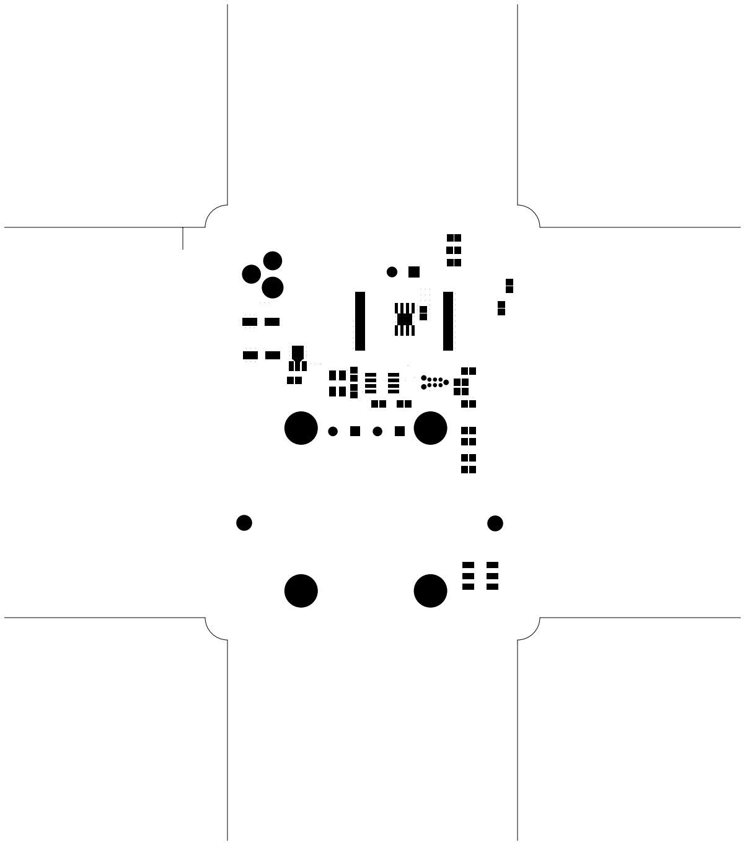
[picture p66: figure]

topmask, scale = 1:1.000

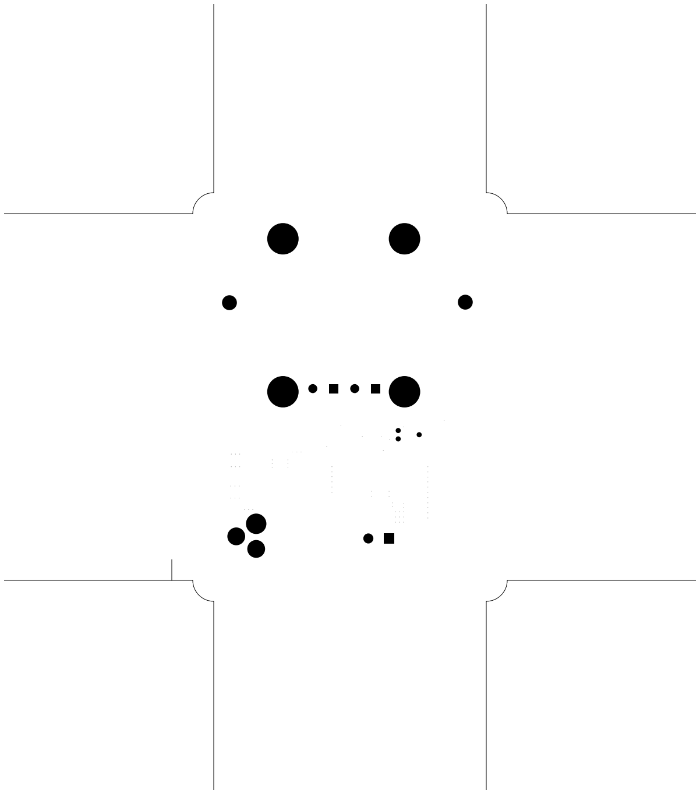
[picture p67: figure]

bottommask (mirrored), scale = 1:1.000

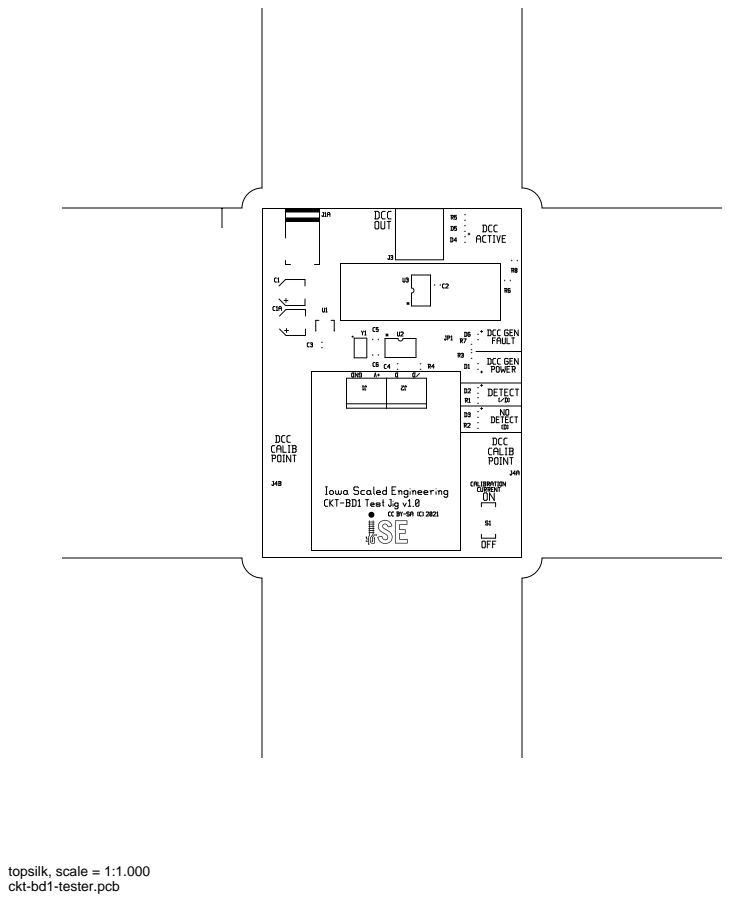
[picture p68: page 9]
topsilk, scale = 1:1.000

bottomsilk (mirrored), scale = 1:1.000

toppaste, scale = 1:1.000

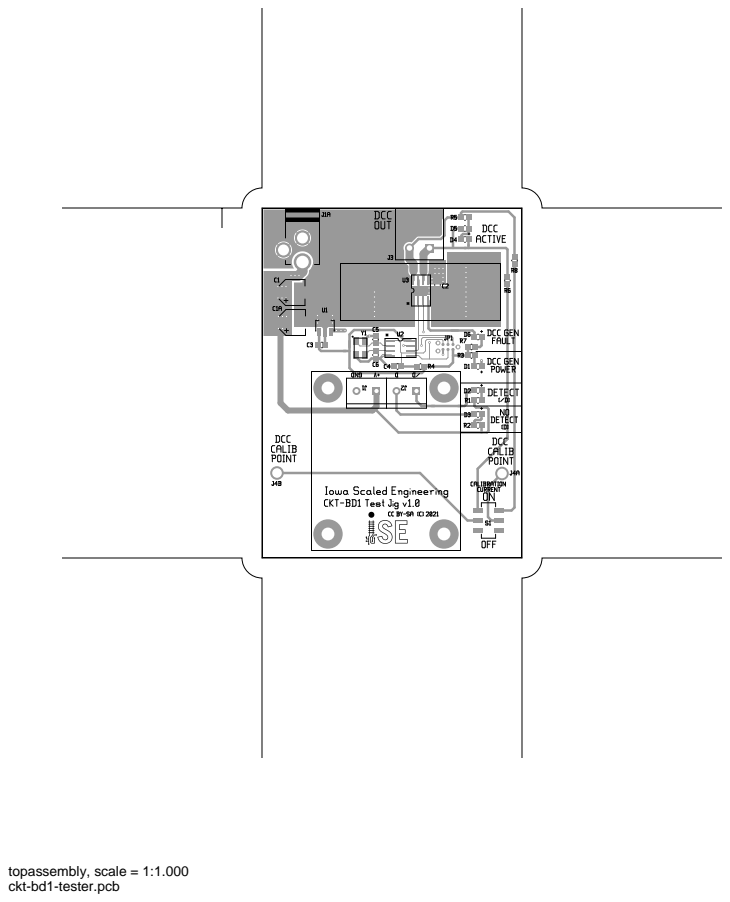
[picture p69: page 12]
topassembly, scale = 1:1.000

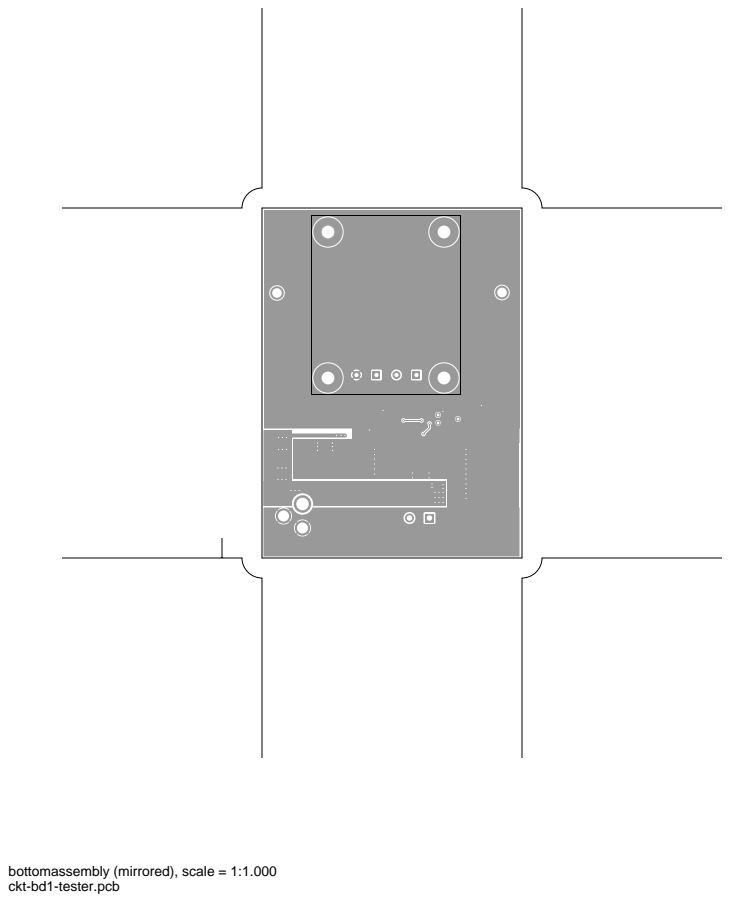
[picture p70: page 13]

bottomassembly (mirrored), scale = 1:1.000

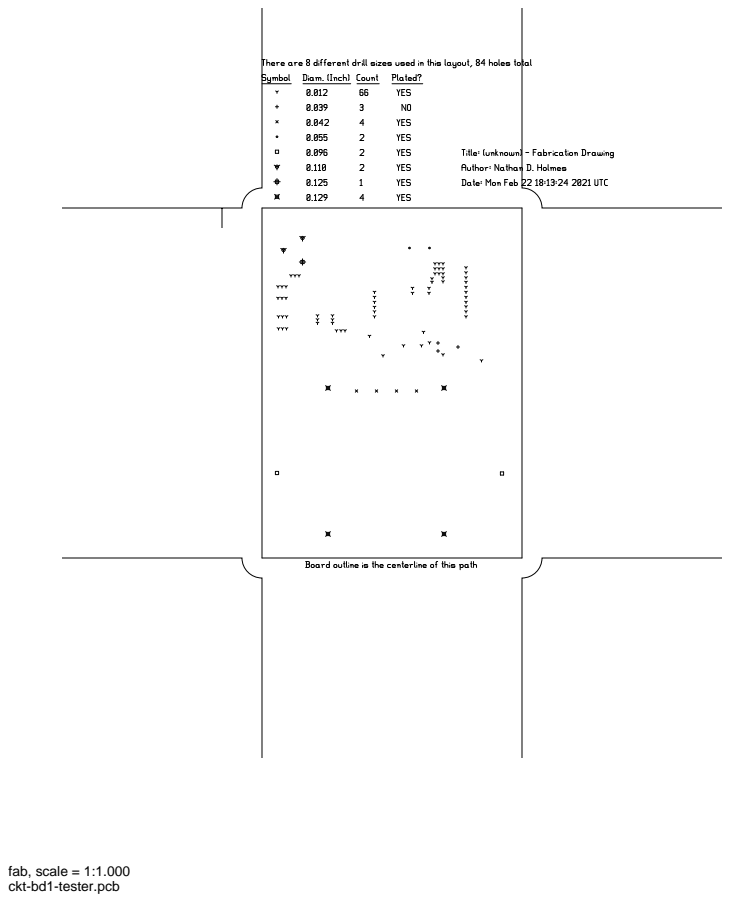
[picture p71: page 14]
fab, scale = 1:1.000
