IowaScaledEngineering/ckt-bd1/pg/ckt-bd1-v4.0-9c7a233/ckt-bd1-pcb.pdf

# ckt-bd1.pcb

# 1. Table of Contents (This Page) Created on Thu Oct 28 09:11:31 2021

# 2. top 3. bottom 4. outline 5. plated-drill 6. unplated-drill 7. componentmask 8. soldermask 9. topsilk 10. bottomsilk 11. toppaste 12. topassembly 13. bottomassembly 14. fab

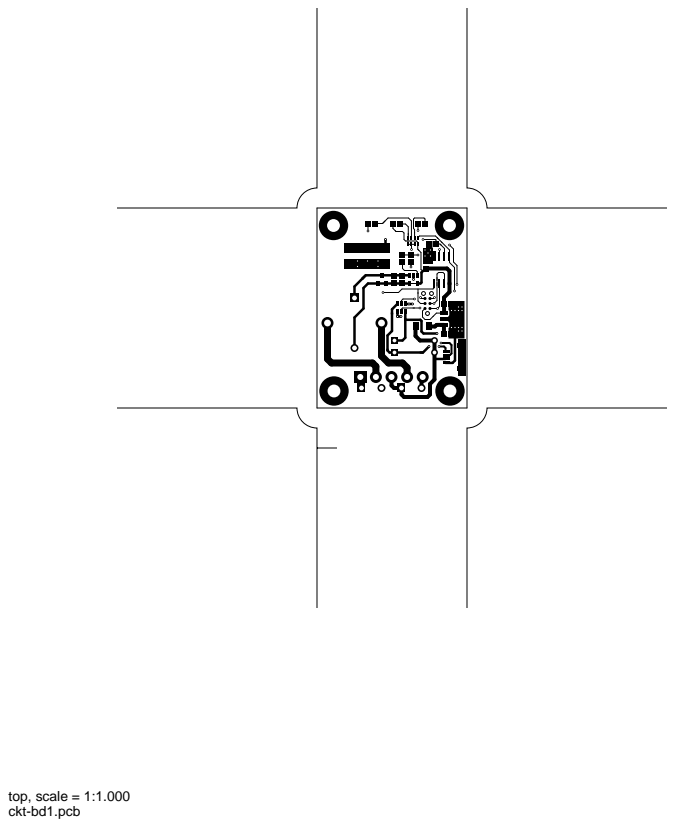
[picture p72: page 2]
top, scale = 1:1.000

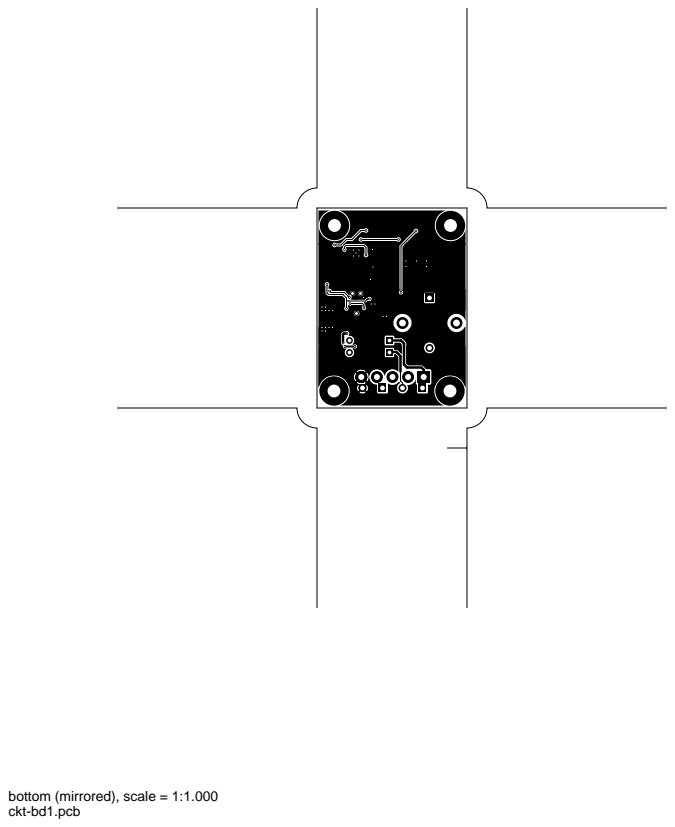
[picture p73: page 3]

bottom (mirrored), scale = 1:1.000

outline, scale = 1:1.000

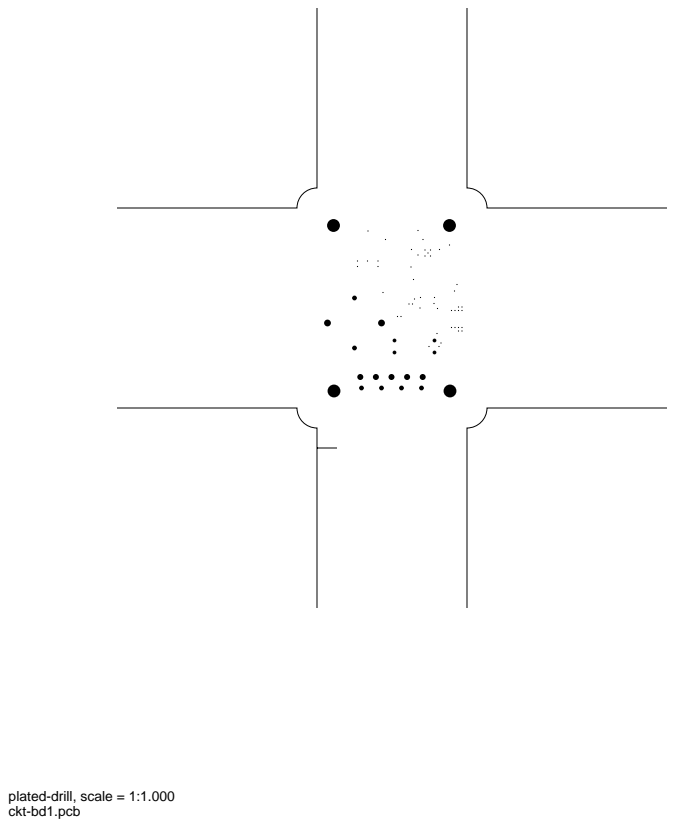
[picture p74: page 5]

plated-drill, scale = 1:1.000

unplated-drill, scale = 1:1.000

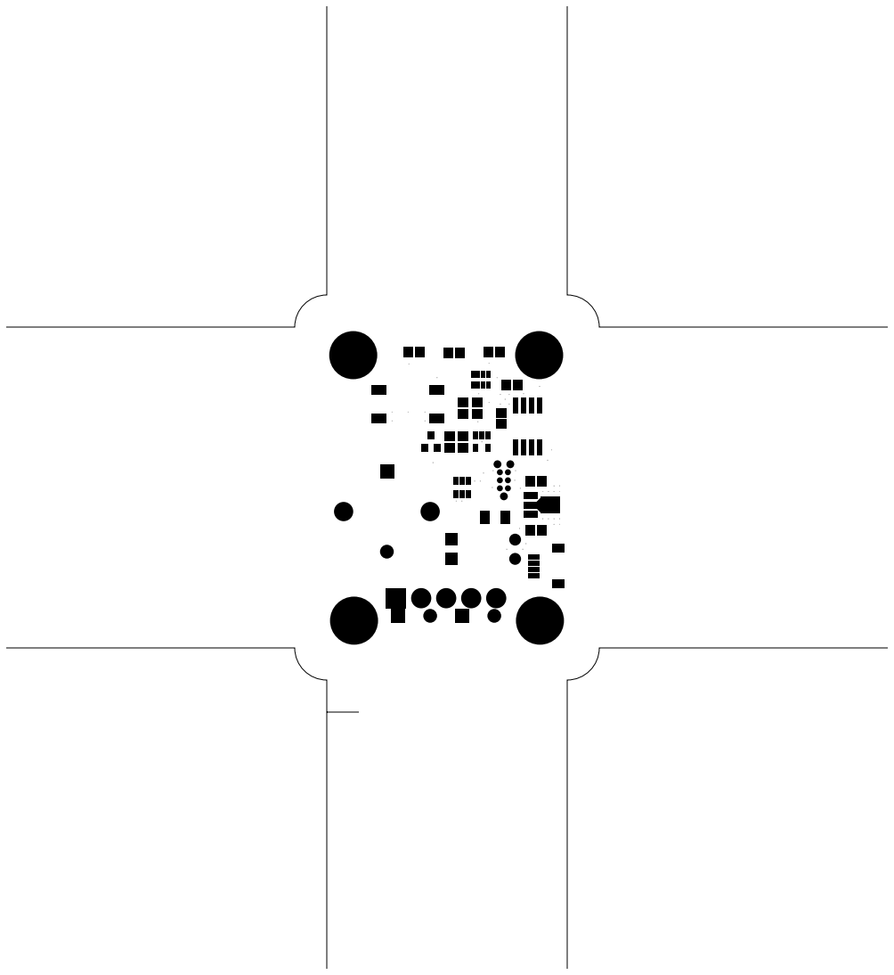
[picture p75: figure]

topmask, scale = 1:1.000

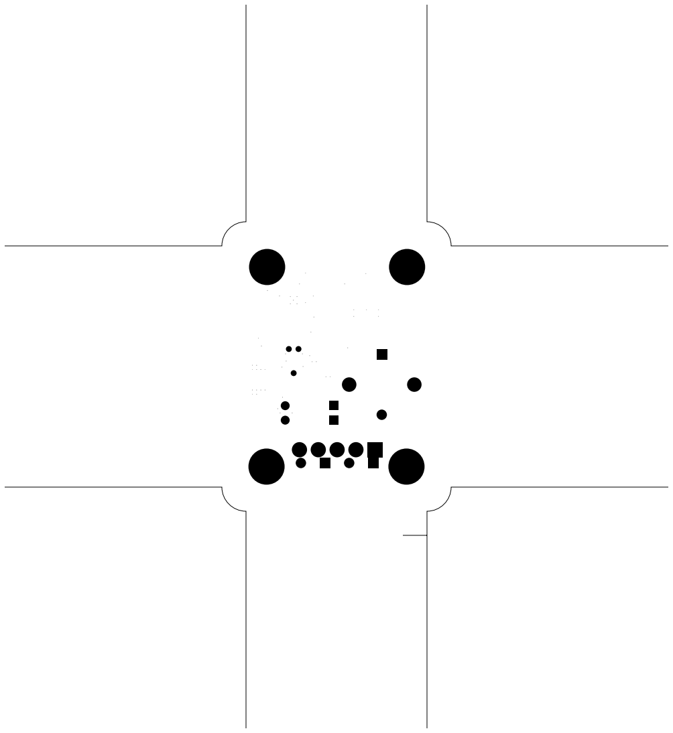
[picture p76: figure]

bottommask (mirrored), scale = 1:1.000

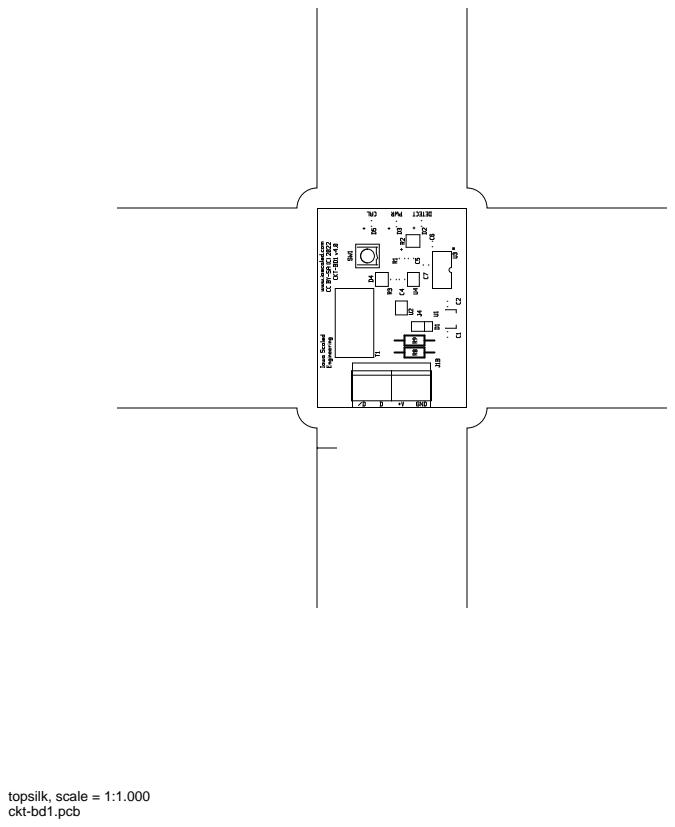
[picture p77: page 9]
topsilk, scale = 1:1.000

bottomsilk (mirrored), scale = 1:1.000

toppaste, scale = 1:1.000

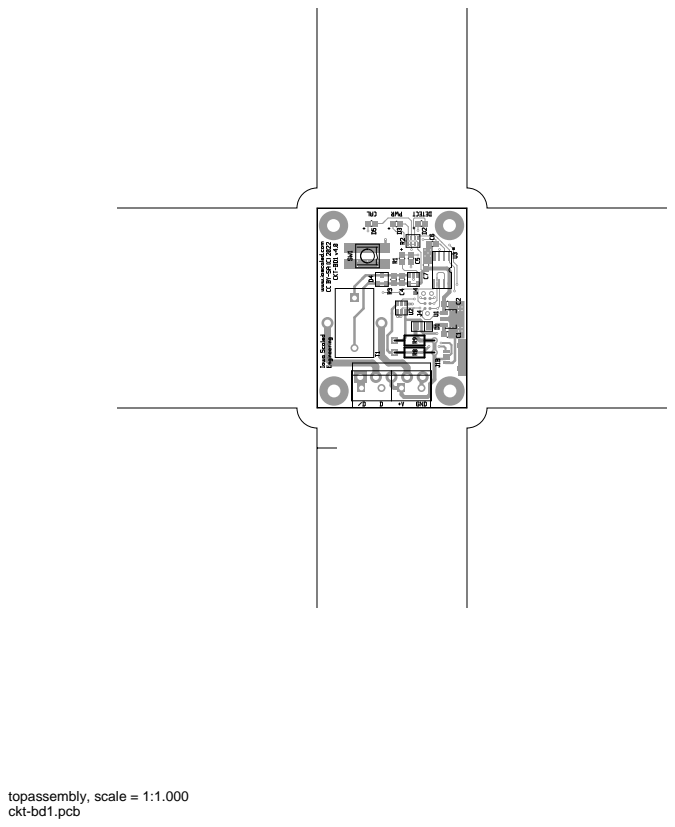
[picture p78: page 12]
topassembly, scale = 1:1.000

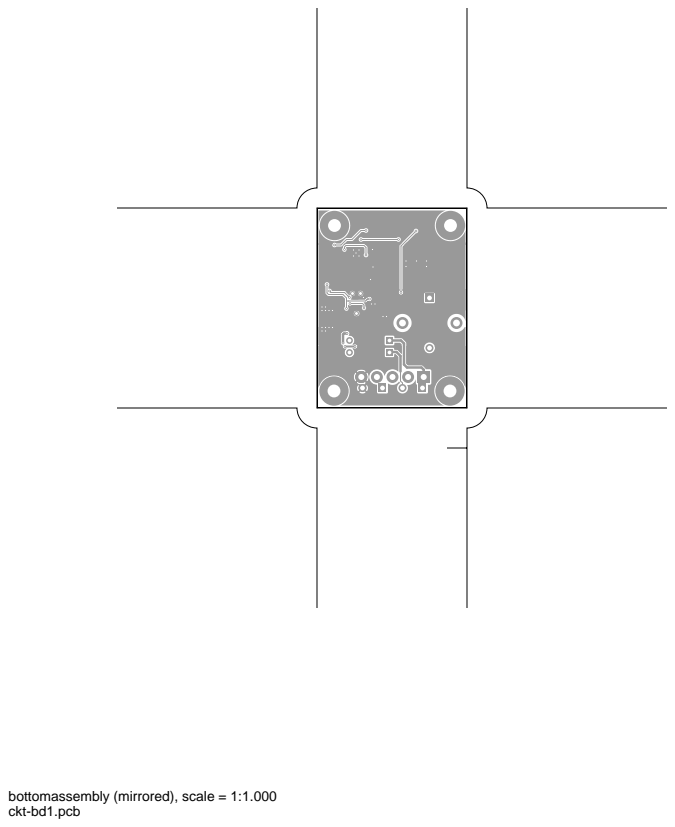
[picture p79: page 13]

bottomassembly (mirrored), scale = 1:1.000

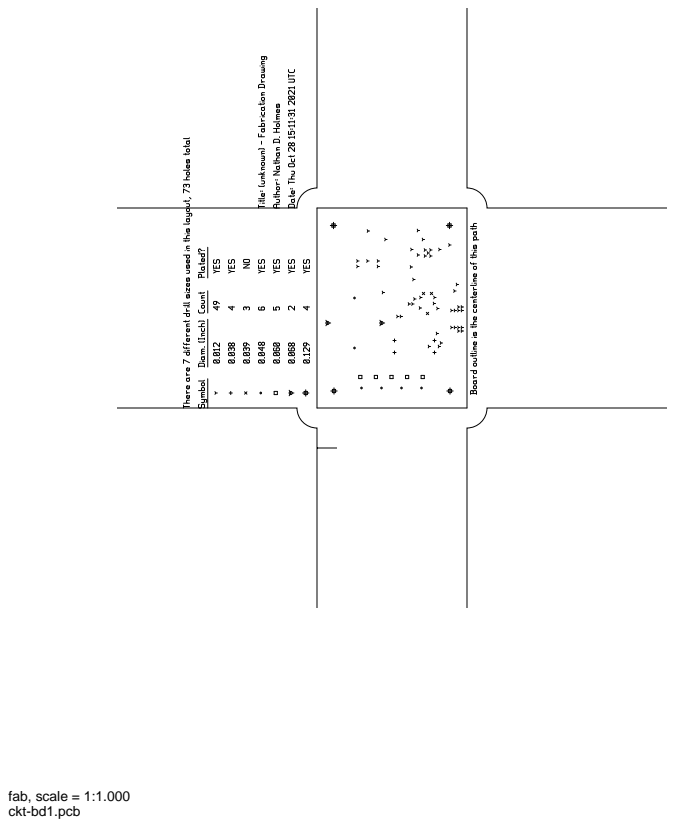
[picture p80: page 14]
fab, scale = 1:1.000
