IowaScaledEngineering/ckt-bd1/pg/ckt-bd1-v3.0-453da1f/ckt-bd1-pcb.pdf

# ckt-bd1.pcb

# 1. Table of Contents (This Page) Created on Wed Apr 15 09:26:37 2020

# 2. top 3. bottom 4. outline 5. plated-drill 6. unplated-drill 7. componentmask 8. soldermask 9. topsilk 10. bottomsilk 11. toppaste 12. topassembly 13. bottomassembly 14. fab

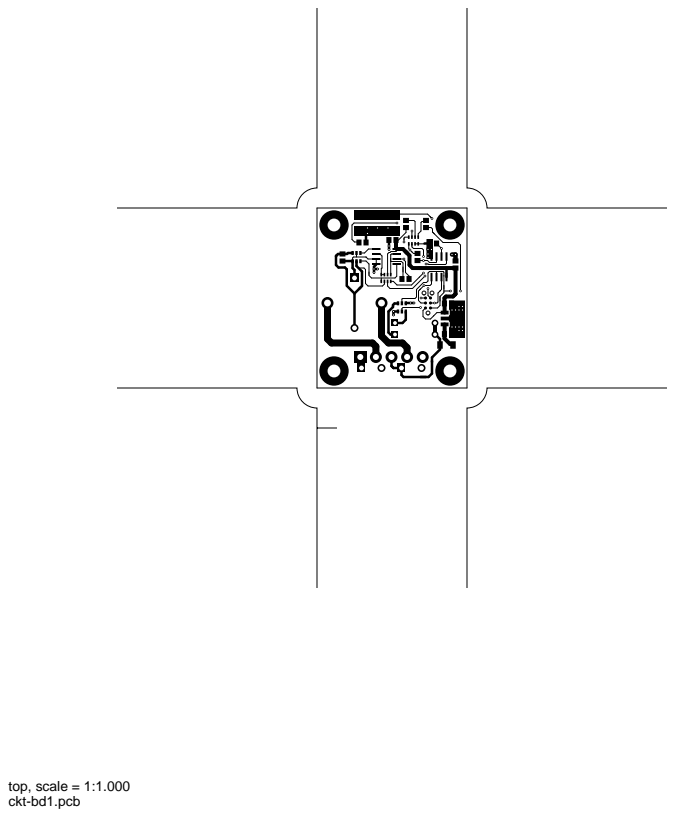
[picture p81: page 2]
top, scale = 1:1.000

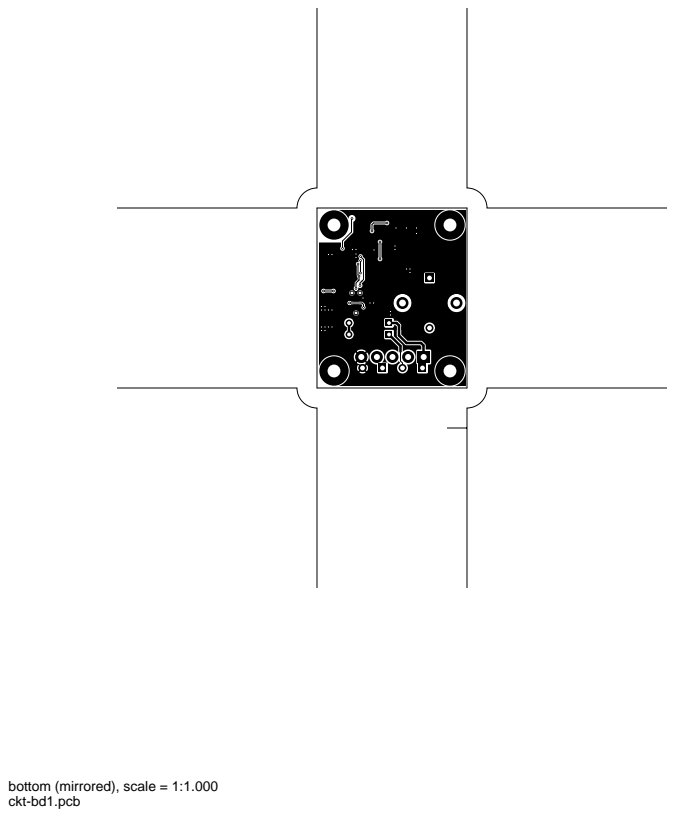
[picture p82: page 3]

bottom (mirrored), scale = 1:1.000

outline, scale = 1:1.000

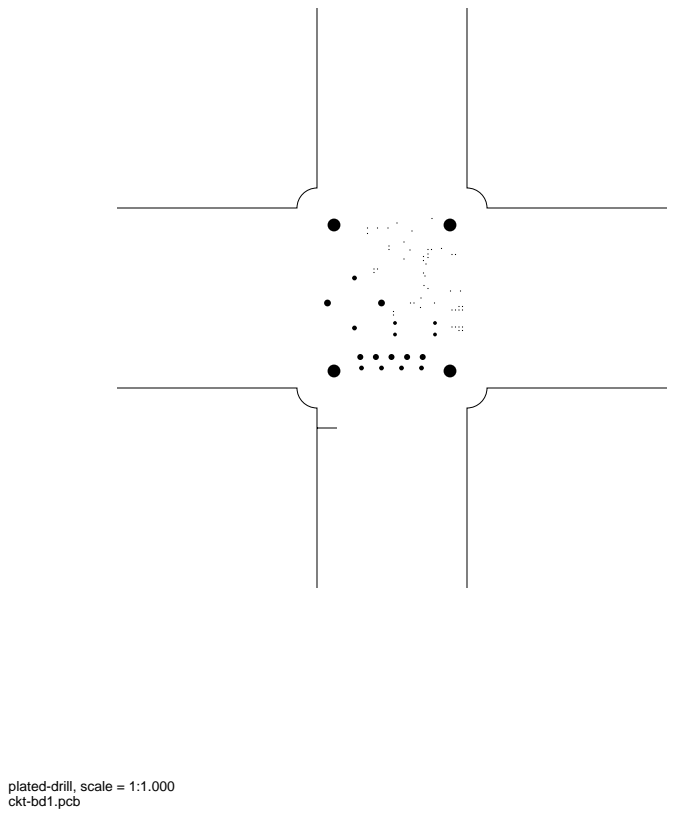
[picture p83: page 5]

plated-drill, scale = 1:1.000

unplated-drill, scale = 1:1.000

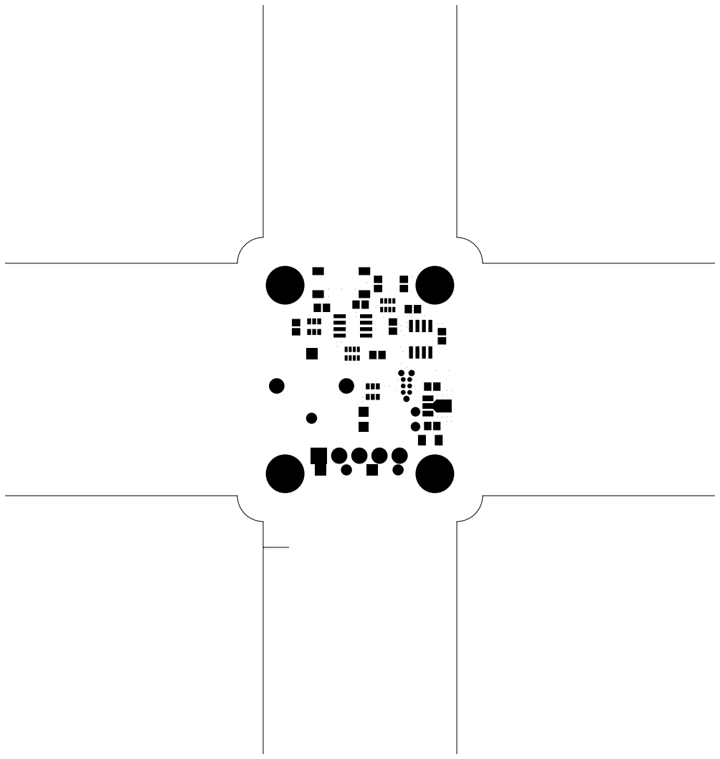
[picture p84: figure]

topmask, scale = 1:1.000

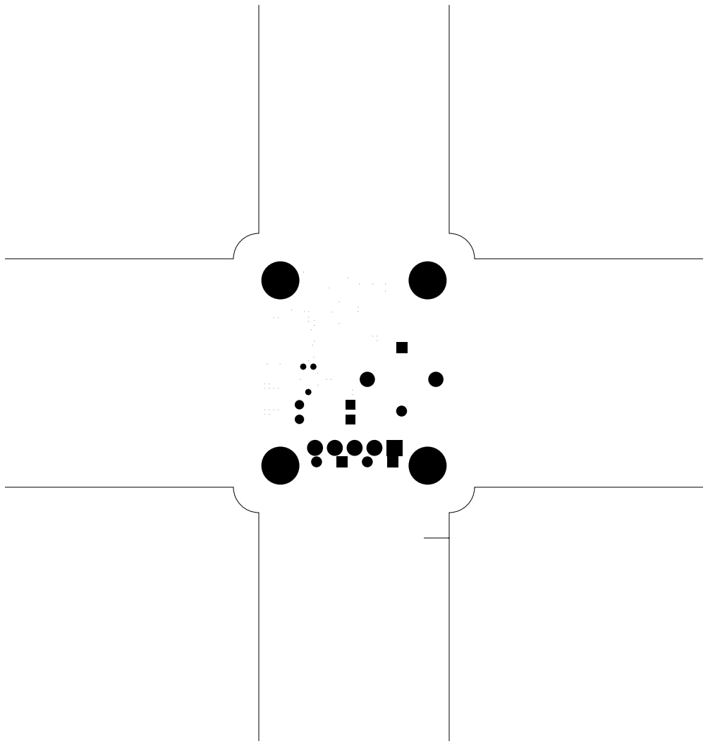
[picture p85: figure]

bottommask (mirrored), scale = 1:1.000

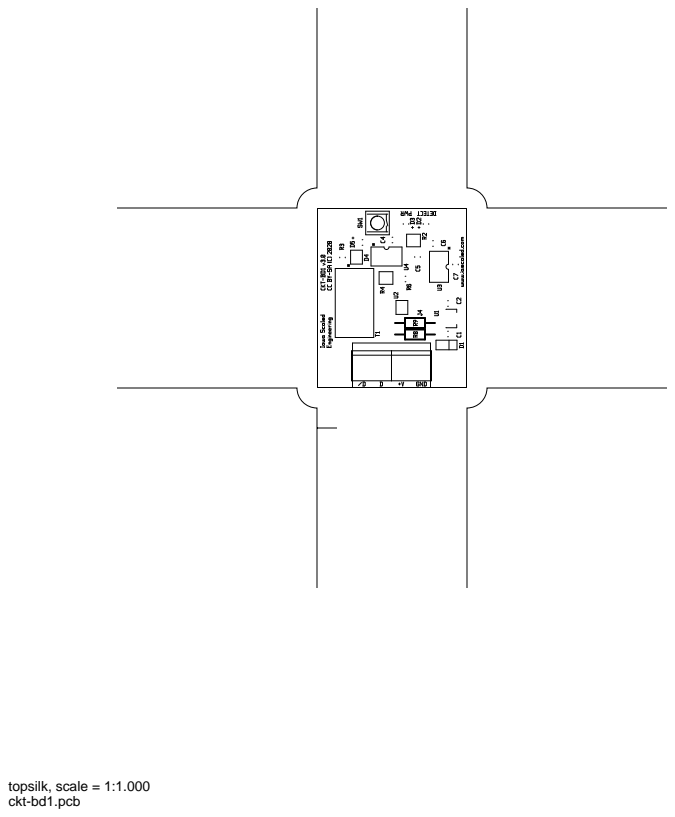
[picture p86: page 9]
topsilk, scale = 1:1.000

bottomsilk (mirrored), scale = 1:1.000

toppaste, scale = 1:1.000

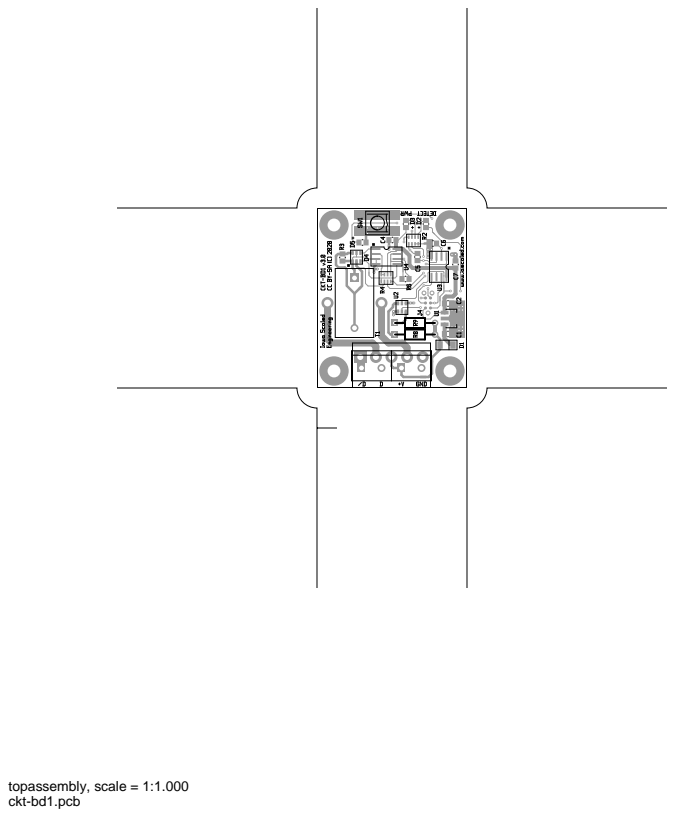
[picture p87: page 12]
topassembly, scale = 1:1.000

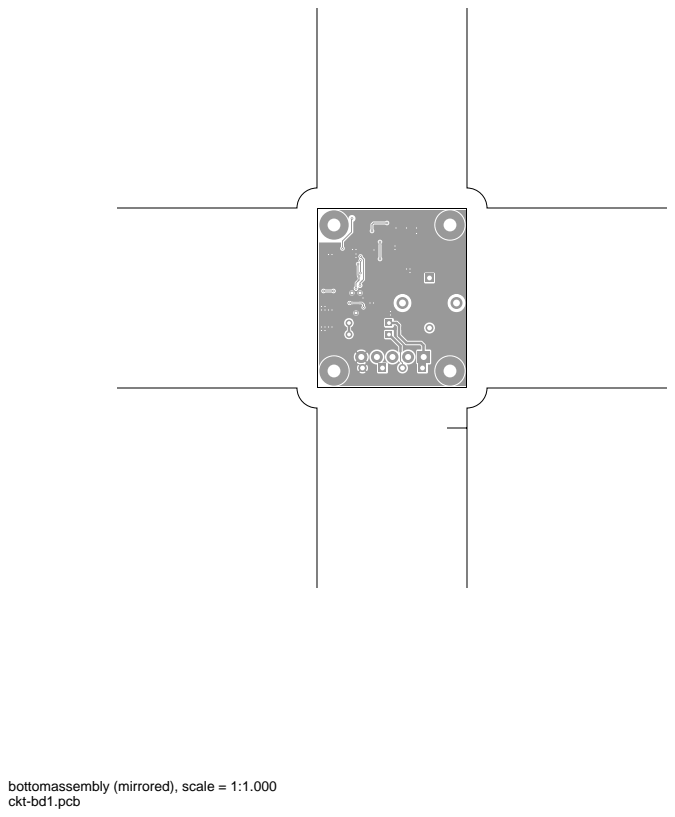
[picture p88: page 13]

bottomassembly (mirrored), scale = 1:1.000

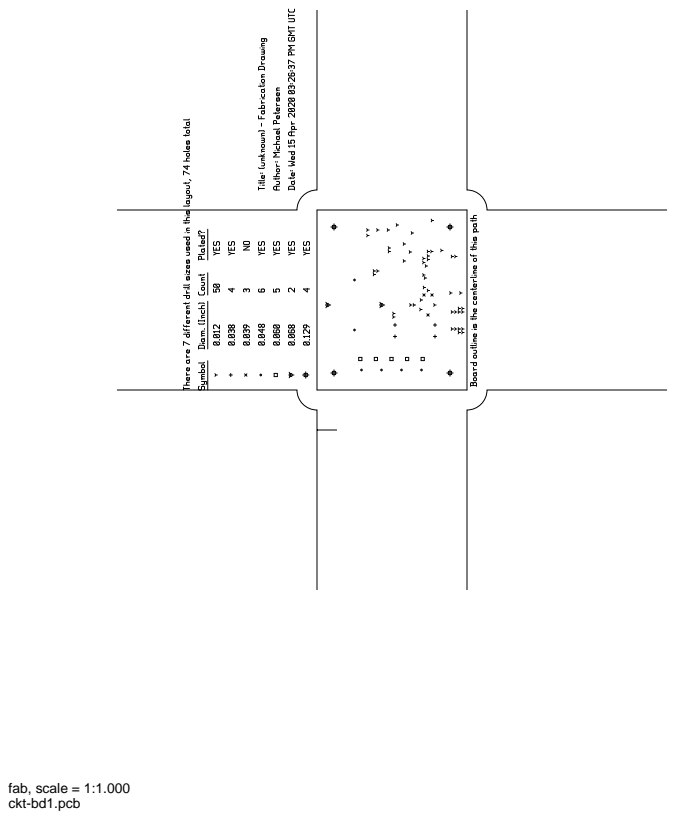
[picture p89: page 14]
fab, scale = 1:1.000
