IowaScaledEngineering/ckt-bd1/pg/ckt-bd1-v2.0-c70ae3b/ckt-bd1-pcb.pdf

# ckt-bd1.pcb

# 1. Table of Contents (This Page) Created on Sun Jan 28 18:11:03 2018

# 2. top 3. bottom 4. outline 5. plated-drill 6. unplated-drill 7. componentmask 8. soldermask 9. topsilk 10. bottomsilk 11. toppaste 12. topassembly 13. bottomassembly 14. fab

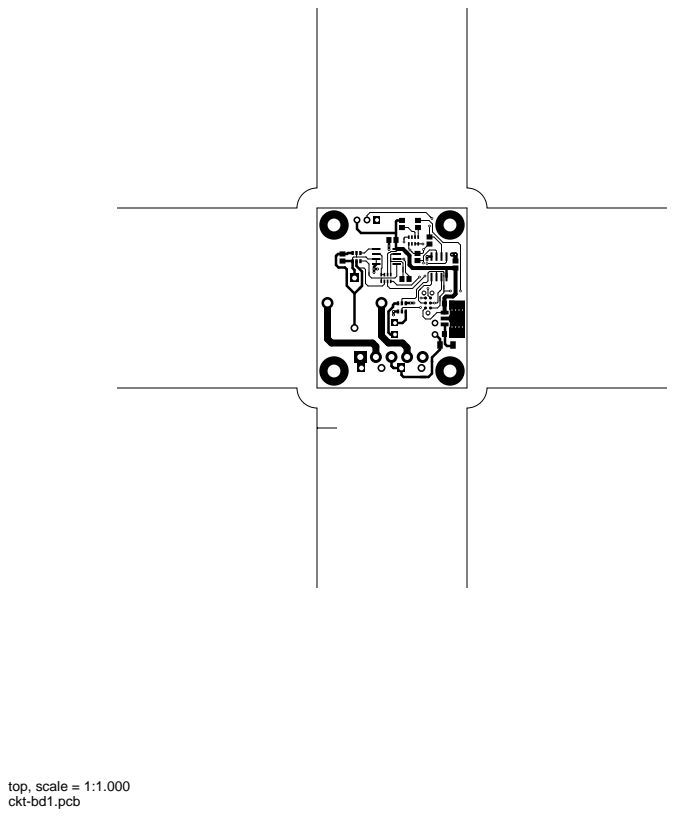
[picture p90: page 2]
top, scale = 1:1.000

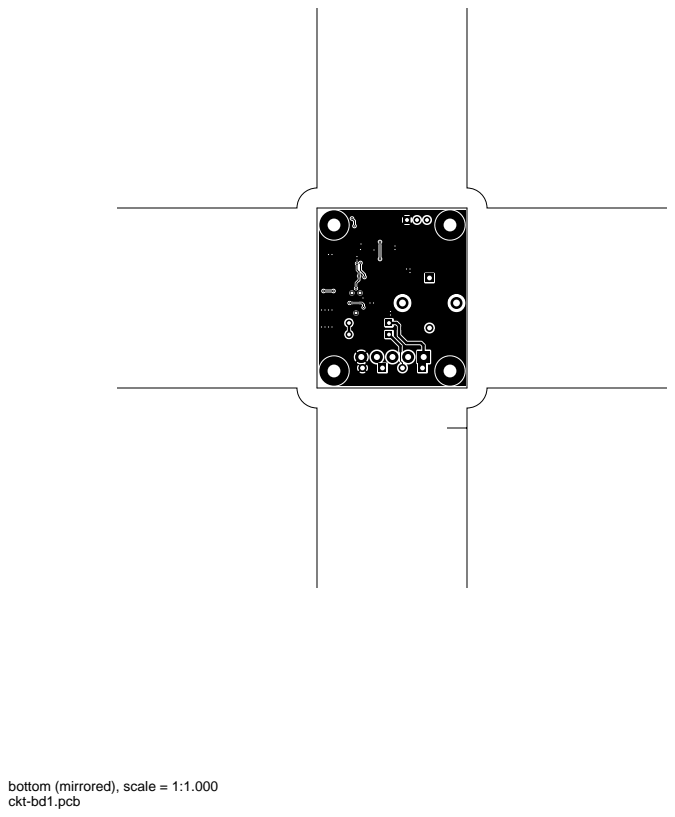
[picture p91: page 3]

bottom (mirrored), scale = 1:1.000

outline, scale = 1:1.000

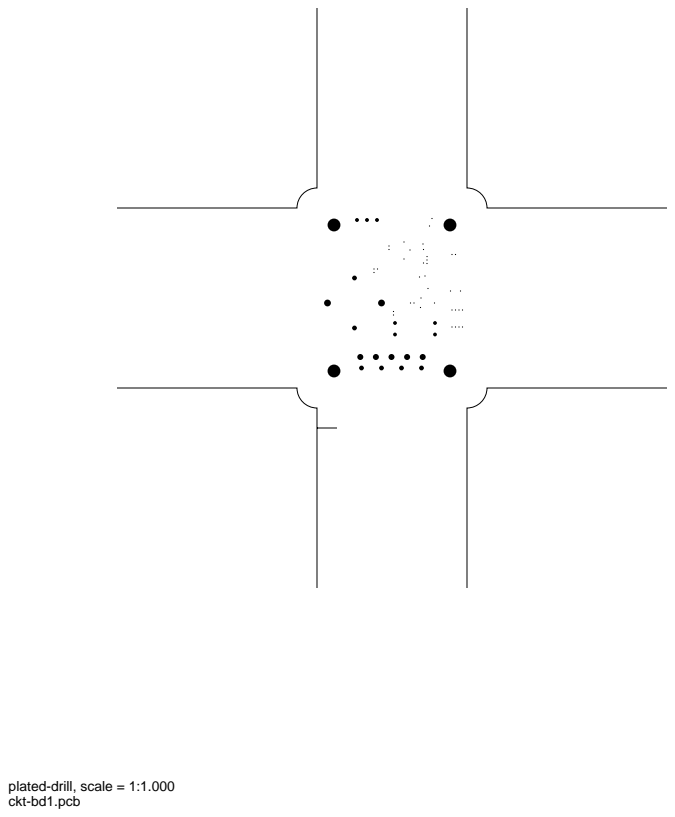
[picture p92: page 5]

plated-drill, scale = 1:1.000

unplated-drill, scale = 1:1.000

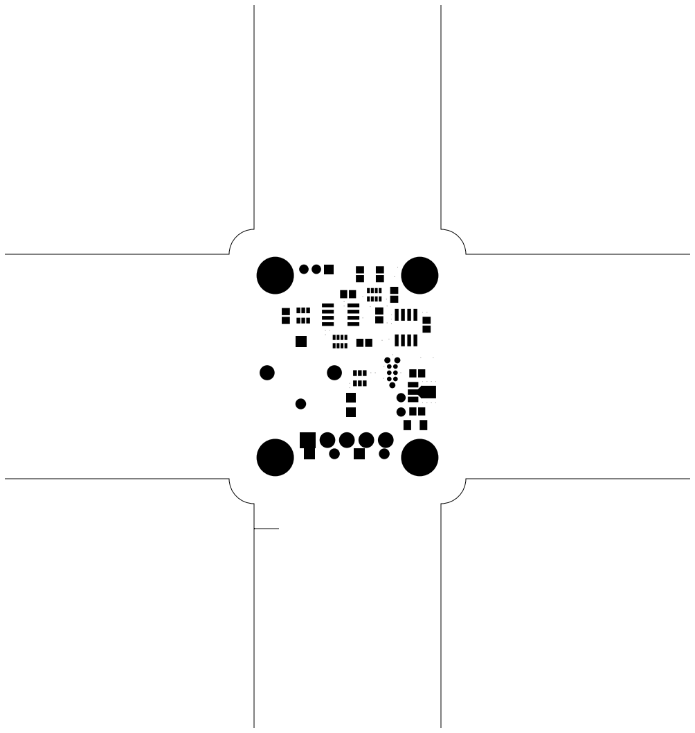
[picture p93: figure]

topmask, scale = 1:1.000

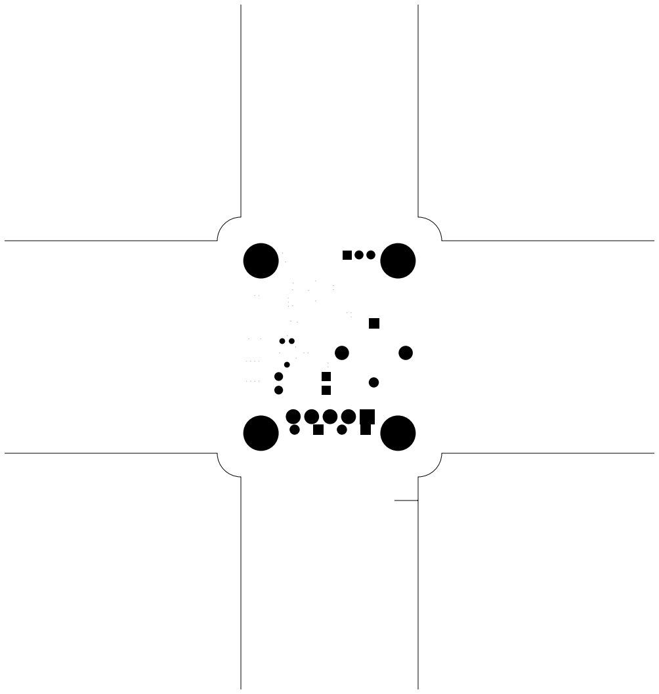
[picture p94: figure]

bottommask (mirrored), scale = 1:1.000

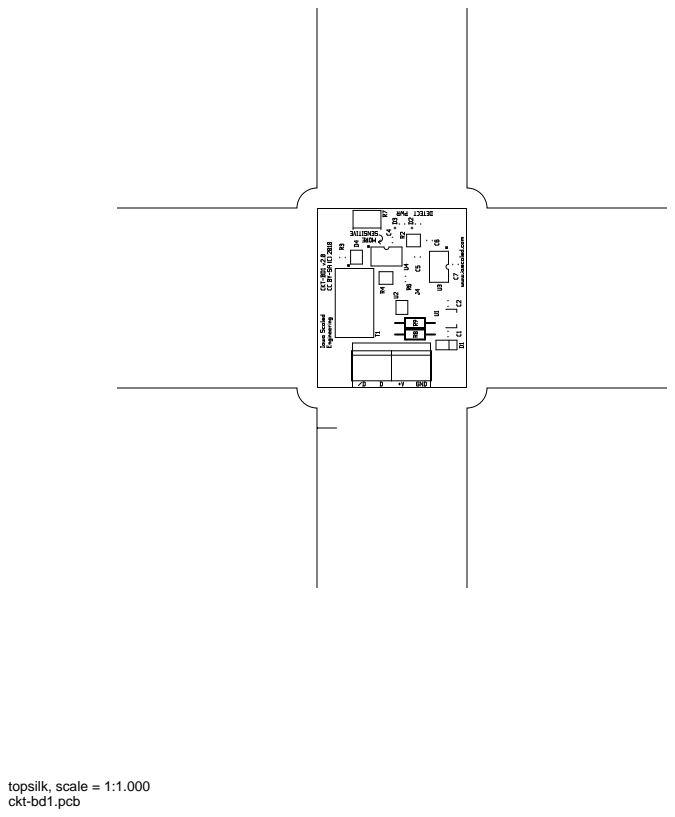
[picture p95: page 9]
topsilk, scale = 1:1.000

bottomsilk (mirrored), scale = 1:1.000

toppaste, scale = 1:1.000

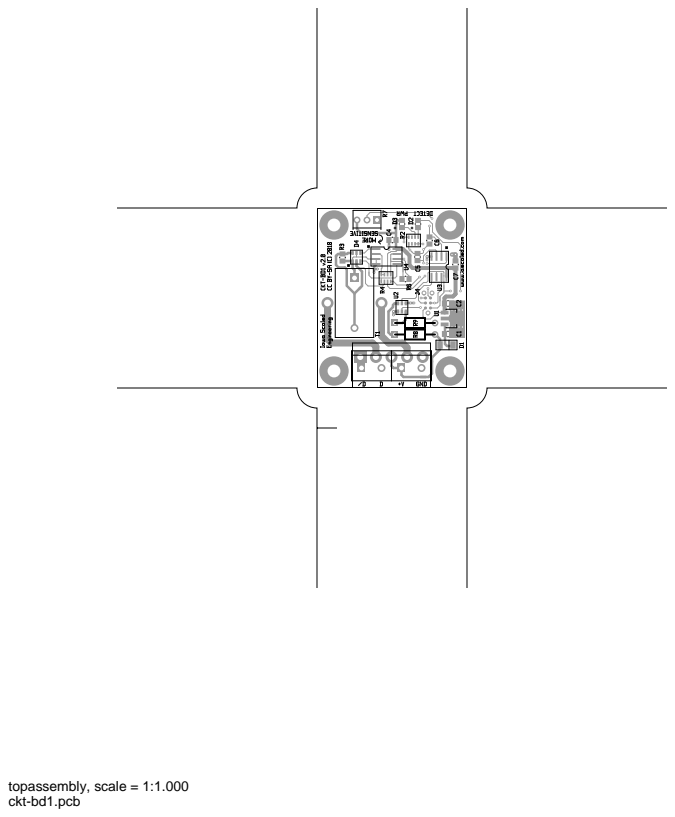
[picture p96: page 12]
topassembly, scale = 1:1.000

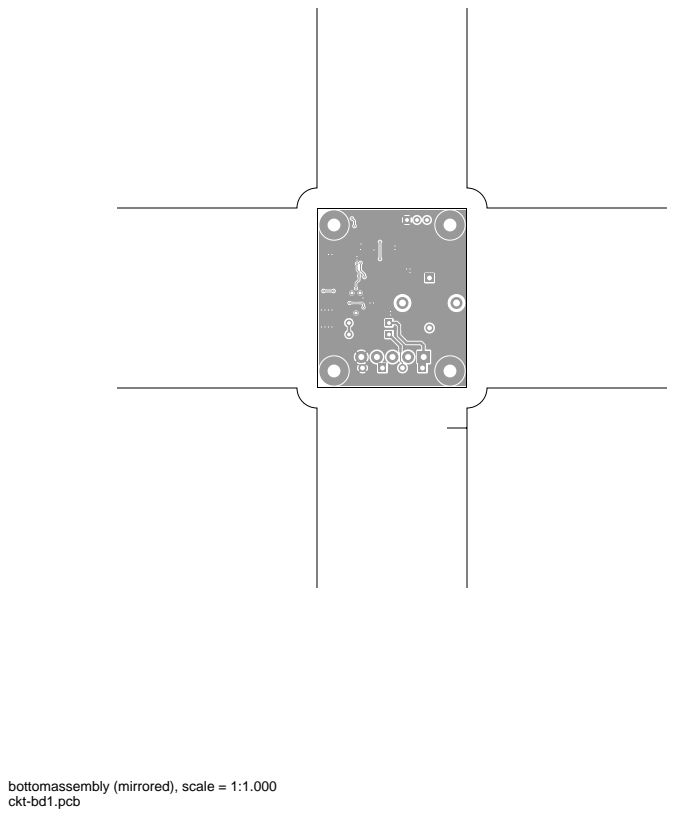
[picture p97: page 13]

bottomassembly (mirrored), scale = 1:1.000

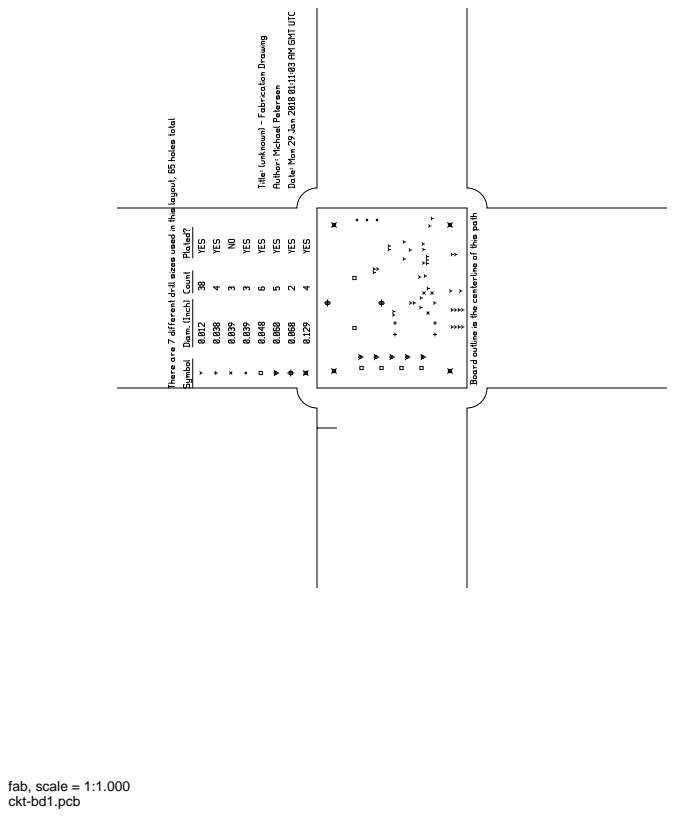
[picture p98: page 14]
fab, scale = 1:1.000
