IowaScaledEngineering/ckt-bd1/pg/ckt-bd1-v1.0-518a714/ckt-bd1-pcb.pdf

# ckt-bd1.pcb

# 1. Table of Contents (This Page) Created on Thu Jan 21 09:01:36 2016

# 2. top 3. bottom 4. outline 5. plated-drill 6. unplated-drill 7. componentmask 8. soldermask 9. topsilk 10. bottomsilk 11. toppaste 12. topassembly 13. bottomassembly 14. fab

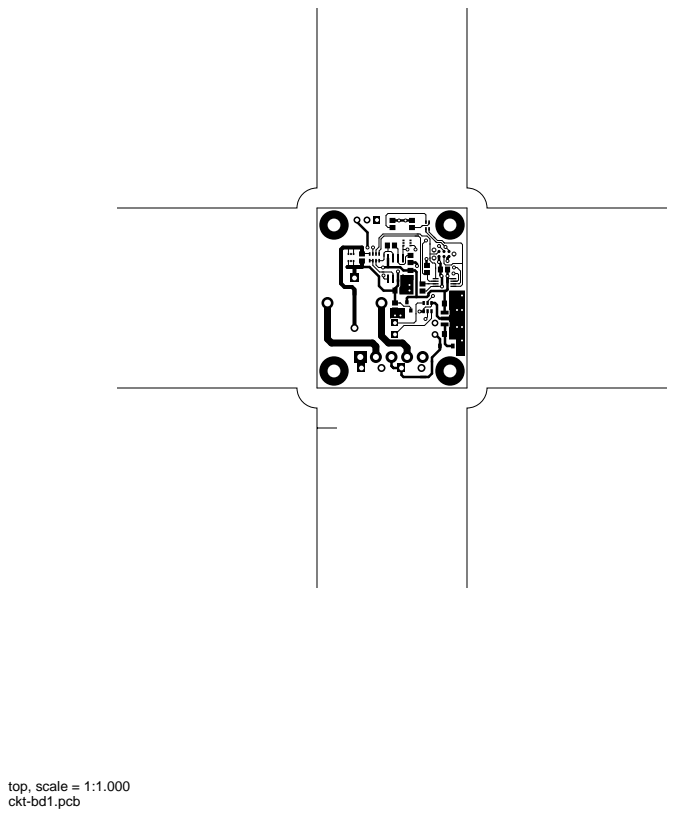
[picture p99: page 2]
top, scale = 1:1.000

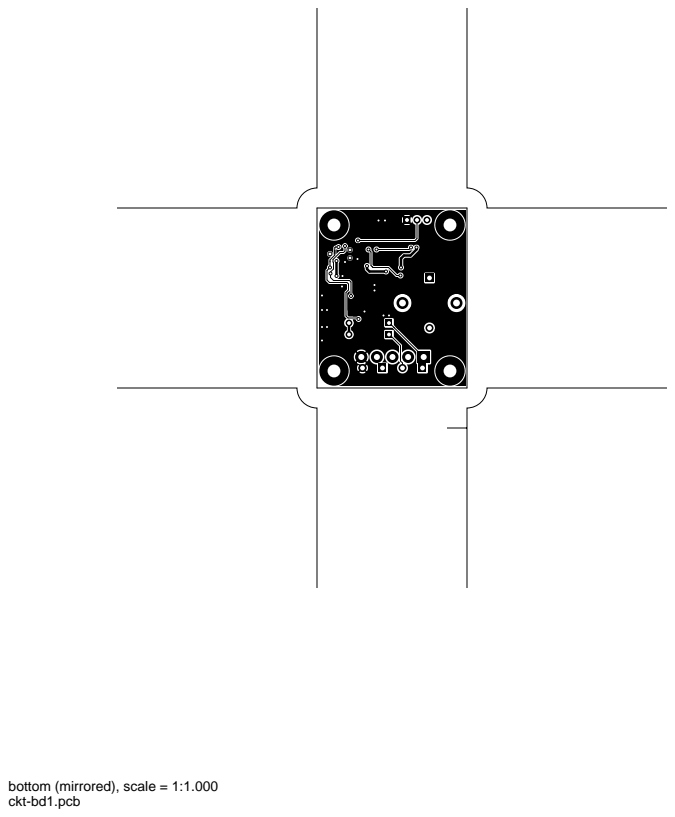
[picture p100: page 3]

bottom (mirrored), scale = 1:1.000

outline, scale = 1:1.000

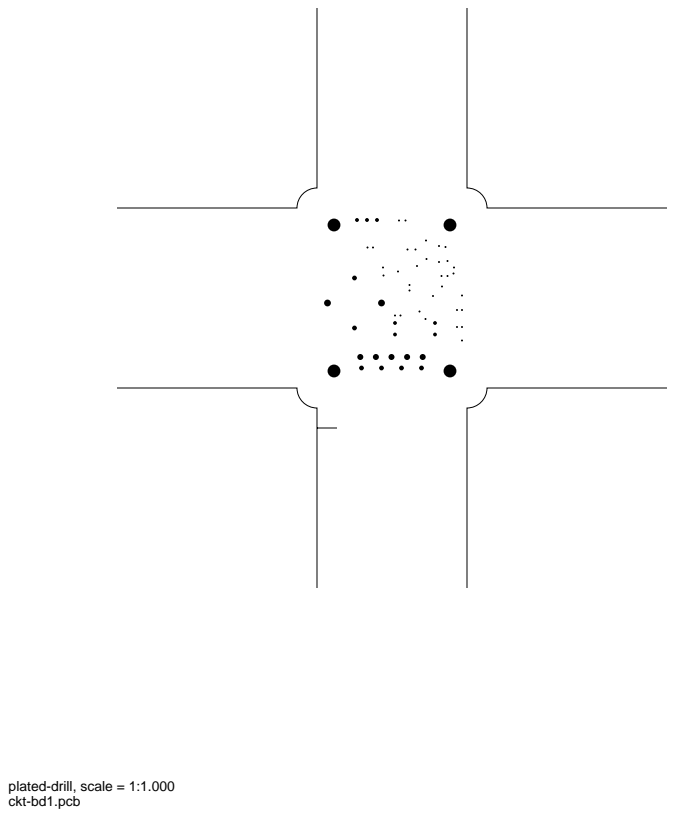
[picture p101: page 5]

plated-drill, scale = 1:1.000

unplated-drill, scale = 1:1.000

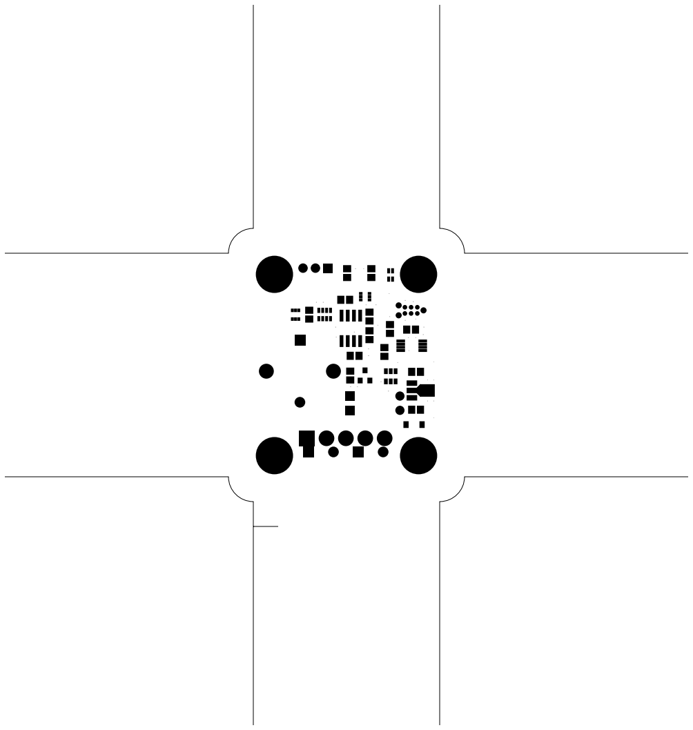
[picture p102: figure]

topmask, scale = 1:1.000

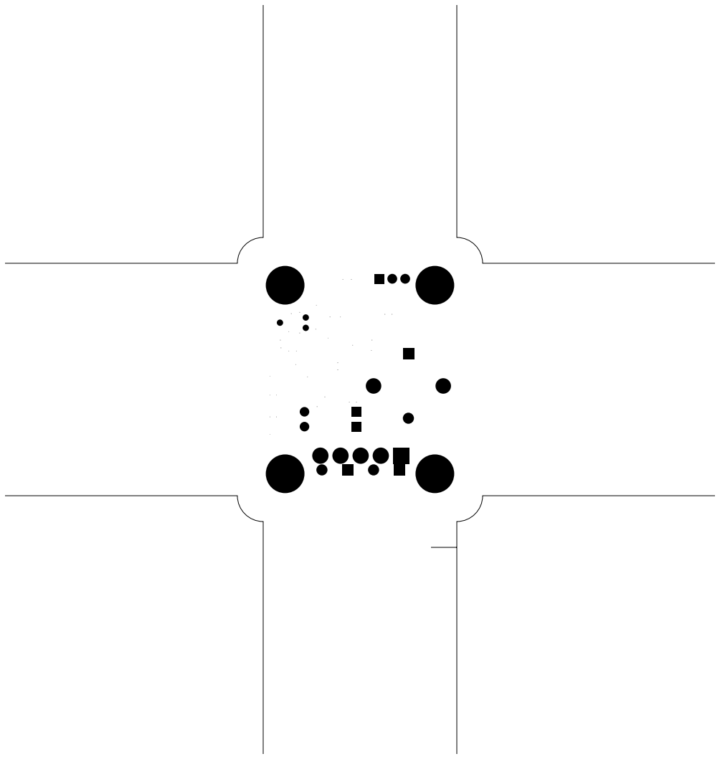
[picture p103: figure]

bottommask (mirrored), scale = 1:1.000

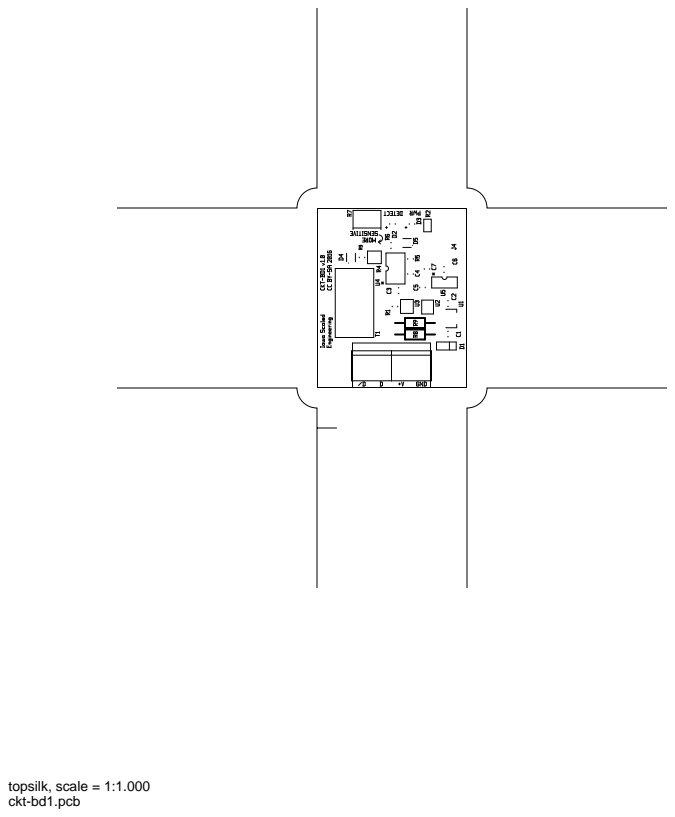
[picture p104: page 9]
topsilk, scale = 1:1.000

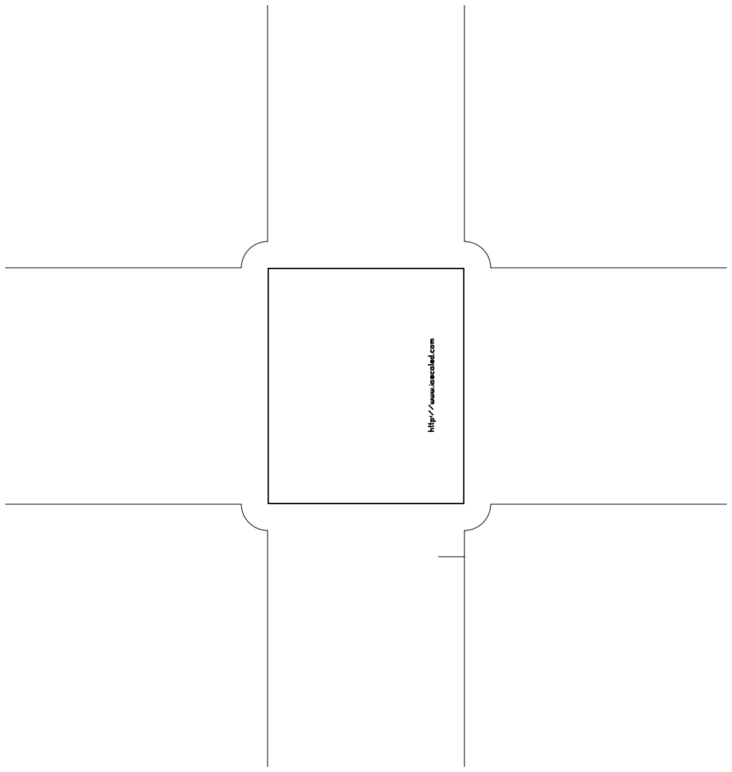
[picture p105: figure]

bottomsilk (mirrored), scale = 1:1.000

toppaste, scale = 1:1.000

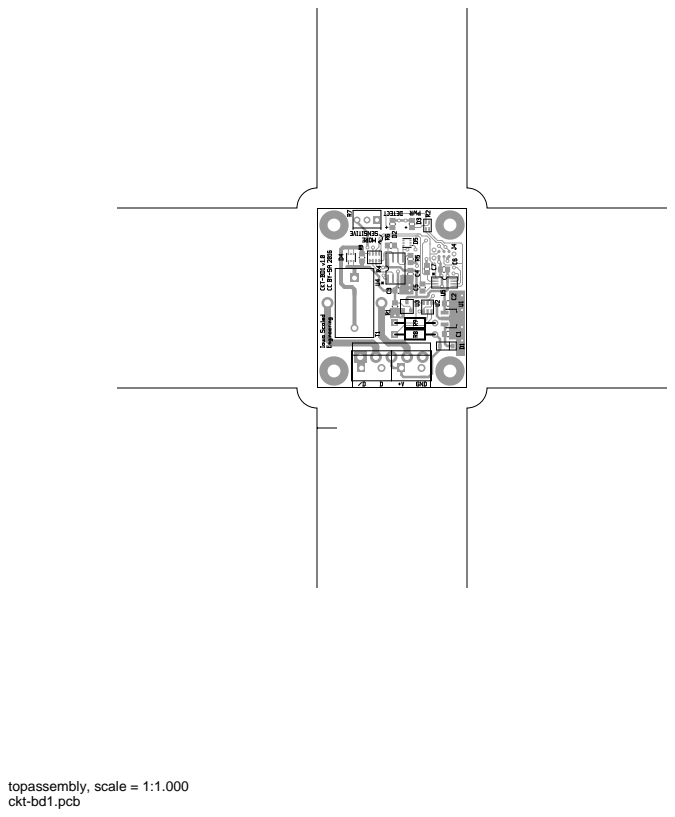
[picture p106: page 12]
topassembly, scale = 1:1.000

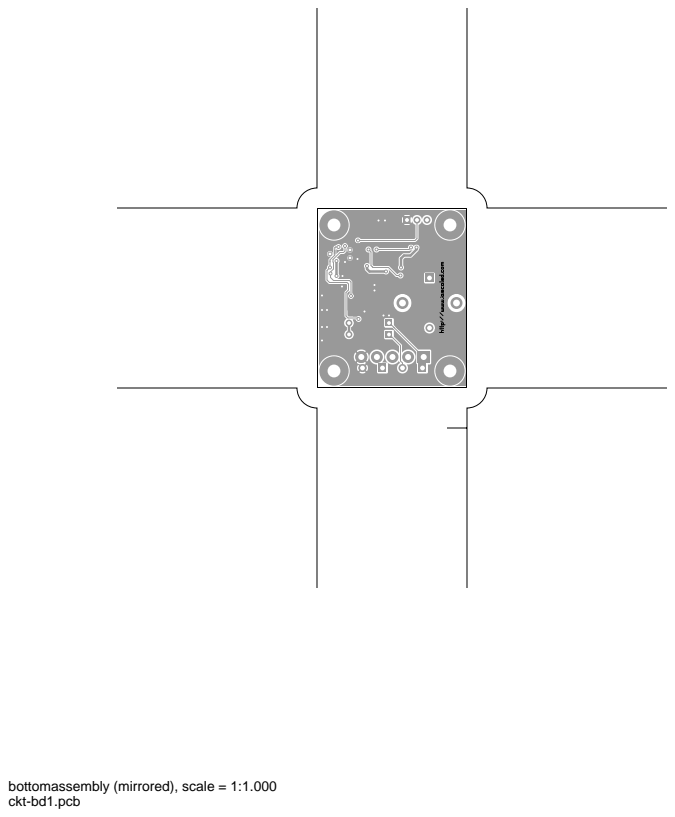
[picture p107: page 13]

bottomassembly (mirrored), scale = 1:1.000

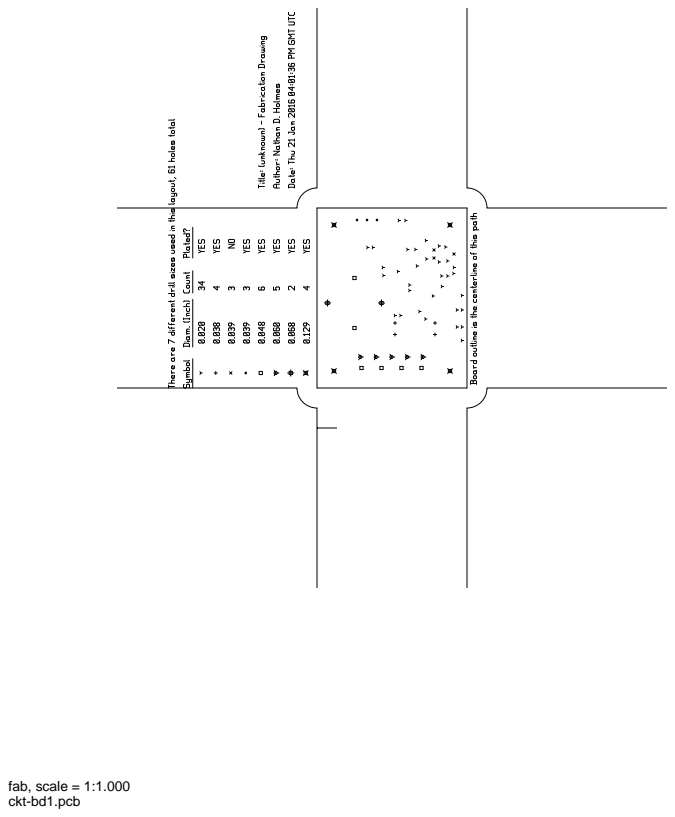
[picture p108: page 14]
fab, scale = 1:1.000
