IowaScaledEngineering/ckt-bd1/(list of files, drawings)

Other design files:
pcb/ckt-bd1-array.pcb
pcb/ckt-bd1-cal.pcb
pcb/ckt-bd1-tester.pcb
pcb/ckt-bd1-v4eval.pcb
pcb/ckt-bd1.pcb
