IowaScaledEngineering/ckt-bd1/kicad/bd-tester/bd-tester.kicad_pcb

## KiCad design kicad/bd-tester/bd-tester.kicad_pcb (2026-03-18)

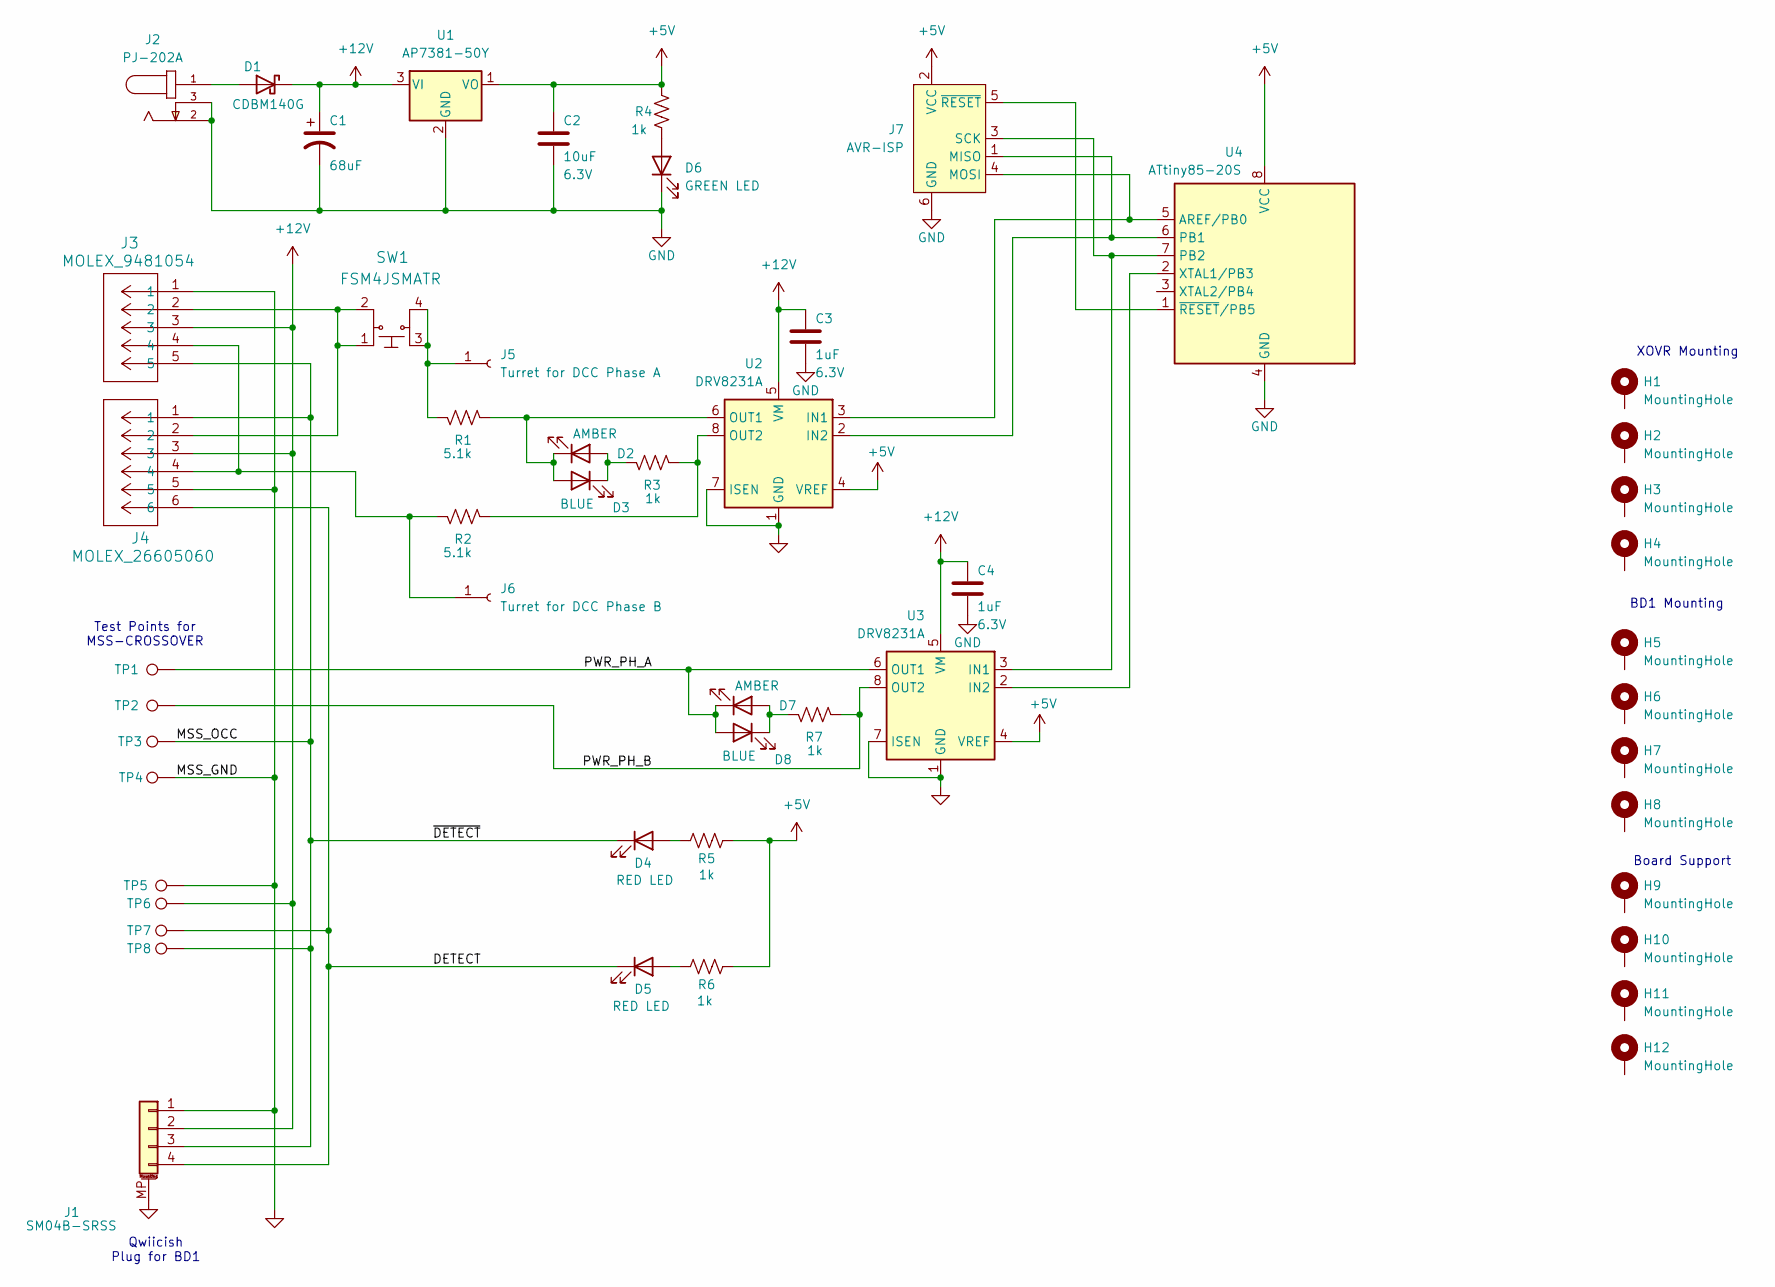
[picture p109: schematic bd-tester.kicad_sch, MSS Crossover Block Detector]

Parts:
C1: 68uF; CP_Elec_6.3x5.8
C2: 10uF; C_0805_2012Metric; Voltage 6.3V
C3, C4: 1uF; C_0805_2012Metric; Voltage 6.3V
D1: CDBM140G; SOD-123T
D2, D7: AMBER; LED_0805_2012Metric
D3, D8: BLUE; LED_0805_2012Metric
D4, D5: RED LED; LED_0805_2012Metric
D6: GREEN LED; LED_0805_2012Metric
H1, H2, H3, H4, H5, H6, H7, H8, H9, H10, H11, H12: MountingHole; MountingHole_3.2mm_M3_Pad
J1: SM04B-SRSS; JST_SH_SM04B-SRSS-TB_1x04-1MP_P1.00mm_Horizontal
J2: PJ-202A; CUI_PJ-202A
J3: MOLEX_9481054
J4: MOLEX_26605060
J5: Turret for DCC Phase A; MountingHole_2.7mm_Pad
J6: Turret for DCC Phase B; MountingHole_2.7mm_Pad
J7: AVR-ISP; Tag-Connect_TC2030-IDC-NL_2x03_P1.27mm_Vertical
R1, R2: 5.1k; R_0805_2012Metric
R3, R4, R5, R6, R7: 1k; R_0805_2012Metric
SW1: FSM4JSMATR; TE_FSM4JSMA; MPN FSM4JSMATR; Digi-Key_PN 450-1759-1-ND
TP1, TP5: TestPoint; TestPoint_THTPad_3.0x3.0mm_Drill1.5mm
TP2, TP3, TP4, TP6, TP7, TP8: TestPoint; TestPoint_THTPad_D3.0mm_Drill1.5mm
U1: AP7381-50Y; SOT-89-3
U2, U3: DRV8231A; Texas_HTSOP-8-1EP_3.9x4.9mm_P1.27mm_EP2.95x4.9mm_Mask2.4x3.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
U4: ATtiny85-20S; ATMEL_SO8_DUAL

Connections:
+5V: C2.1, J7.2 (VCC), R4.2, R5.1, R6.1, U1.1 (VO), U2.4 (VREF), U3.4 (VREF), U4.8 (VCC)
+12V: C1.1, C3.1, C4.1, D1.1 (K), J1.2, J3.3, J4.3, TP6.1, U1.3 (VI), U2.5 (VM), U3.5 (VM)
/DETECT: D5.1 (K), J1.4, J4.6, TP7.1
/MSS_OCC: D4.1 (K), J1.3, J3.5, J4.1, TP3.1, TP8.1
/PWR_PH_A: D7.1 (K), D8.2 (A), TP1.1, U3.6 (OUT1)
/PWR_PH_B: R7.2, TP2.1, U3.8 (OUT2)
GND: C1.2, C2.2, C3.2, C4.2, D6.1 (K), J1.1, J1.MP (MountPin), J2.2, J2.3, J3.1, J4.5, J7.6 (GND), TP4.1, TP5.1, U1.2 (GND), U2.1 (GND), U2.7 (ISEN), U2.9 (GND), U3.1 (GND), U3.7 (ISEN), U3.9 (GND), U4.4 (GND)
unnamed: D1.2 (A), J2.1
unnamed: D2.2 (A), D3.1 (K), R3.1
unnamed: D2.1 (K), D3.2 (A), R1.2, U2.6 (OUT1)
unnamed: D4.2 (A), R5.2
unnamed: D5.2 (A), R6.2
unnamed: D6.2 (A), R4.1
unnamed: D7.2 (A), D8.1 (K), R7.1
unnamed: J3.2, J4.2, SW1.1, SW1.2
unnamed: J5.1, R1.1, SW1.3, SW1.4
unnamed: J3.4, J4.4, J6.1, R2.1
unnamed: J7.1 (MISO), U2.2 (IN2), U4.6 (PB1)
unnamed: J7.4 (MOSI), U2.3 (IN1), U4.5 (AREF/PB0)
unnamed: J7.3 (SCK), U3.3 (IN1), U4.7 (PB2)
unnamed: J7.5 (~RESET), U4.1 (~RESET/PB5)
unnamed: R2.2, R3.2, U2.8 (OUT2)
unnamed: U3.2 (IN2), U4.2 (XTAL1/PB3)

Notes on the sheet:
Board Support
Qwiicish Plug for BD1
XOVR Mounting
BD1 Mounting
Test Points for MSS-CROSSOVER

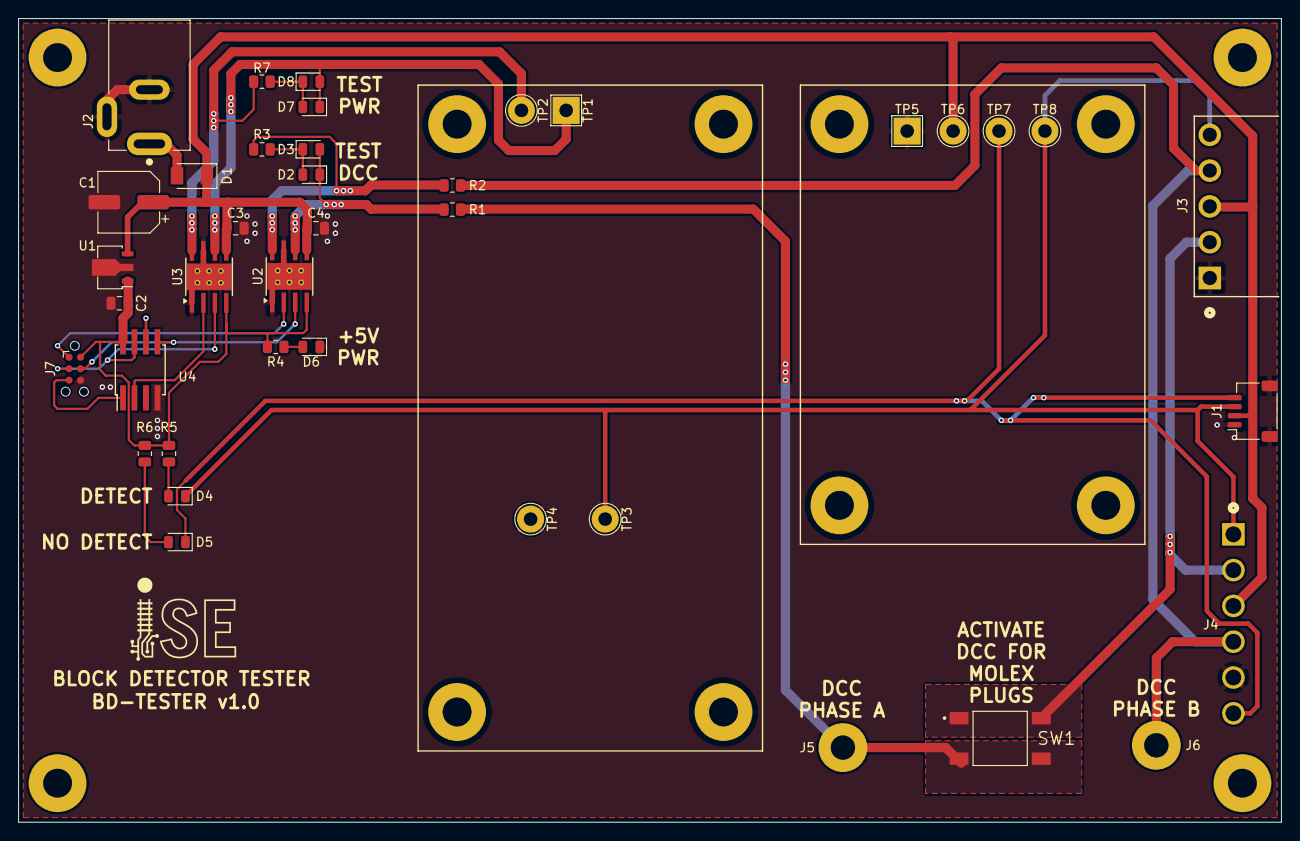
[picture p110: board bd-tester.kicad_pcb from above]

Board: 2 copper layers, 139.7 x 88.9 mm, 51 parts (0 on the bottom side), 23 nets.
