IowaScaledEngineering/ckt-bd1/(commit log)

2016-01-14 Add provision for pull-up resistor
    [ckt-bd1.sch]
2016-01-14 Oops, forgot to save first
    [ckt-bd1.sch]
2016-01-14 Update cmri footprint add project file
2016-01-15 BD1 circuit board
    [ckt-bd1.pcb, ckt-bd1.sch]
2016-01-18 Moved the plus sign for one LED
    [ckt-bd1.pcb]
2016-01-18 Minor review cleanup
    [ckt-bd1.pcb, ckt-bd1.sch]
2016-01-18 Modifications per design review, part 2 Add R9 for pulling up the other lead
    [ckt-bd1.pcb, ckt-bd1.sch]
2016-02-05 PG of v1.0
    [ckt-bd1.GBL, ckt-bd1.GBO, ckt-bd1.GBS, ckt-bd1.GKO, ckt-bd1.GTL, ckt-bd1.GTO, ckt-bd1.GTS, ckt-bd1.bottom.gbr]
2016-02-14 First cut of working firmware
2018-01-03 New symbol for SOT26 diode
2018-01-03 Modify BD1 to use SOT26 diode
    [ckt-bd1.sch]
2018-01-05 New v2.0 design based on testing to remove VBIAS
    [ckt-bd1.pcb, ckt-bd1.sch]
2018-01-05 Minor refdes cleanup
    [ckt-bd1.pcb]
2018-01-06 Updated voltage range. Added new logo. Minor formatting changes.
2018-01-06 Remove 78L33 text from regulator
2018-01-06 Updates per Michael's review
    [ckt-bd1.pcb, ckt-bd1.sch]
2018-01-29 Sent to fab v2.0
    [ckt-bd1.bottom.gbr, ckt-bd1.bottommask.gbr, ckt-bd1.bottompaste.gbr, ckt-bd1.bottomsilk.gbr, ckt-bd1.fab.gbr, ckt-bd1.outline.gbr, ckt-bd1.top.gbr, ckt-bd1.topmask.gbr]
2020-01-28 Fixed bug where the ADC was getting retriggered by EVENT_DO_ADC_RUN not getting cleared once the conversion process had started
    [ckt-bd1.c]
2020-04-14 BD1 v3 - changed out pot for switch, added set indicator LED, fixed + on other two LEDs
    [ckt-bd1.pcb, ckt-bd1.sch]
2020-04-14 Fix to move button away from screw hole
    [ckt-bd1.pcb]
2020-04-15 Sent to fab 4/15/2020
    [ckt-bd1.bottom.gbr, ckt-bd1.bottommask.gbr, ckt-bd1.bottompaste.gbr, ckt-bd1.bottomsilk.gbr, ckt-bd1.fab.gbr, ckt-bd1.outline.gbr, ckt-bd1.top.gbr, ckt-bd1.topmask.gbr]
2020-06-21 Added calibration board
    [ckt-bd1-cal.pcb]
2020-06-22 Added planes to top side and some extra text
    [ckt-bd1-cal.pcb]
2020-07-04 Sent to fab 7/2
    [ckt-bd1-cal.bottom.gbr, ckt-bd1-cal.bottommask.gbr, ckt-bd1-cal.bottompaste.gbr, ckt-bd1-cal.bottomsilk.gbr, ckt-bd1-cal.fab.gbr, ckt-bd1-cal.outline.gbr, ckt-bd1-cal.top.gbr, ckt-bd1-cal.topmask.gbr]
2021-02-11 Add tester PCB and SCH
    [ckt-bd1-tester.pcb, ckt-bd1-tester.sch]
2021-02-11 A few minor revisions to the tester
    [ckt-bd1-tester.pcb]
2021-02-12 Forgot the outline layer
    [ckt-bd1-tester.pcb]
2021-02-12 Decrease tester hole size on J1/J2 to accomodate pogos
    [ckt-bd1-tester.pcb]
2021-02-19 Fix C1/C1A text
    [ckt-bd1-tester.pcb]
2021-02-22 Add bd1 test jig pg
    [ckt-bd1-tester.bottom.gbr, ckt-bd1-tester.bottommask.gbr, ckt-bd1-tester.bottompaste.gbr, ckt-bd1-tester.bottomsilk.gbr, ckt-bd1-tester.fab.gbr, ckt-bd1-tester.outline.gbr, ckt-bd1-tester.top.gbr, ckt-bd1-tester.topmask.gbr]
2021-08-08 Add eval board for v4 front end
    [ckt-bd1-v4eval.pcb, ckt-bd1-v4eval.sch, gain-analysis-2.ods, gain-analysis.ods]
2021-08-16 Add ckt-bd1-v4eval
    [ckt-bd1-v4eval.bottom.gbr, ckt-bd1-v4eval.bottommask.gbr, ckt-bd1-v4eval.bottompaste.gbr, ckt-bd1-v4eval.bottomsilk.gbr, ckt-bd1-v4eval.fab.gbr, ckt-bd1-v4eval.outline.gbr, ckt-bd1-v4eval.top.gbr, ckt-bd1-v4eval.topmask.gbr]
2021-10-18 Initial draft v4 schematic
    [ckt-bd1.sch]
2021-10-19 v4 sch and pcb
    [ckt-bd1.pcb, ckt-bd1.sch]
2021-10-27 Add JST connector
    [ckt-bd1.pcb, ckt-bd1.sch]
2021-10-27 Minor tweak
    [ckt-bd1.pcb]
2021-10-27 Fix note about transformer wiring
    [ckt-bd1.sch]
2021-10-27 Maybe added calibration? Might work?
2021-10-28 PG 4.0
    [ckt-bd1.bottom.gbr, ckt-bd1.bottommask.gbr, ckt-bd1.bottompaste.gbr, ckt-bd1.bottomsilk.gbr, ckt-bd1.fab.gbr, ckt-bd1.outline.gbr, ckt-bd1.top.gbr, ckt-bd1.topmask.gbr]
2021-10-28 Revert "PG 4.0"
    This reverts commit 013a514e4aae1a2b9016e1cb27fa46fe1efc0ed1.
    [ckt-bd1.bottom.gbr, ckt-bd1.bottommask.gbr, ckt-bd1.bottompaste.gbr, ckt-bd1.bottomsilk.gbr, ckt-bd1.fab.gbr, ckt-bd1.outline.gbr, ckt-bd1.top.gbr, ckt-bd1.topmask.gbr]
2021-10-28 Fix issue with WDT
    [ckt-bd1.c]
2021-10-28 Pull back under 5mm
    [ckt-bd1.pcb]
2021-10-28 Revert "Pull back under 5mm"
    This reverts commit 931aaa442d37beda5219071a60c94a440bb77a99.
    [ckt-bd1.pcb]
2021-11-01 Add pg v4.0
    [ckt-bd1.bottom.gbr, ckt-bd1.bottommask.gbr, ckt-bd1.bottompaste.gbr, ckt-bd1.bottomsilk.gbr, ckt-bd1.fab.gbr, ckt-bd1.outline.gbr, ckt-bd1.top.gbr, ckt-bd1.topmask.gbr]
2021-11-20 Fix code for going from dma to count
    [ct-linearize.c]
2021-11-22 Fix linearizer code, reformat
    [ckt-bd1.c, ct-linearize.c]
2021-11-22 No idea what's changed since last time
    [gain-analysis-testboards.ods]
2021-11-22 Modify v4.0 PCB to have 170mil hole-edge spacing - the two at the bottom were wrong Change tester to remove pointless crystal and match new 4.0A board hole spacing
    [ckt-bd1-tester.pcb, ckt-bd1-tester.sch, ckt-bd1.pcb]
2021-11-22 Change tester version back to v4.0A and remove bottom silk BD1 outline
    [ckt-bd1-tester.pcb]
2022-05-15 Add v4.0A bd1 and tester
    [ckt-bd1-tester.bottom.gbr, ckt-bd1-tester.bottommask.gbr, ckt-bd1-tester.bottompaste.gbr, ckt-bd1-tester.bottomsilk.gbr, ckt-bd1-tester.fab.gbr, ckt-bd1-tester.outline.gbr, ckt-bd1-tester.top.gbr, ckt-bd1-tester.topmask.gbr]
2022-06-09 Update to allow for either INA180 or INA181 to deal with supply chain issues
    [ckt-bd1.pcb, ckt-bd1.sch]
2022-09-01 Remove R-pack for better mass assembly
    [ckt-bd1.pcb, ckt-bd1.sch]
2022-09-11 Add solder jumpers and built-in pull up resistors
    [ckt-bd1.pcb, ckt-bd1.sch]
2022-09-18 Change Molex to 6 pin so as to also bring out the DETECT line - potentially for Circuitron use.
    [ckt-bd1.pcb, ckt-bd1.sch]
2022-09-19 Center the 6-pin connector, reroute a bunch of stuff
    [ckt-bd1.pcb, ckt-bd1.sch]
2022-09-19 Change text
    [ckt-bd1.pcb]
2022-10-09 Added panelized array
    [ckt-bd1-array.pcb]
2022-10-15 Pick and place files
    [ckt-bd1-singles.csv]
2022-10-16 Added tabs between boards
    [ckt-bd1-array.pcb]
2022-10-16 Add arrayed BD1s v4.1 now with inter-BD tabs
    [ckt-bd1-array.bottom.gbr, ckt-bd1-array.bottommask.gbr, ckt-bd1-array.bottompaste.gbr, ckt-bd1-array.bottomsilk.gbr, ckt-bd1-array.fab.gbr, ckt-bd1-array.outline.gbr, ckt-bd1-array.top.gbr, ckt-bd1-array.topmask.gbr]
2022-10-27 Usermanual draft material
2022-12-03 Add schematic PDF to the v4.1 array
2022-12-14 Packaging items
    [bd1-blister-box v5.stl]
2023-02-11 Removed pnp files
    [ckt-bd1-singles.csv]
2023-02-24 6x and 12x brackets
    [bd1-12x-blister-box v7.stl, bd1-6x-blister-box v5.stl]
2023-05-17 Added 12x labels, updated print settings.
2026-03-17 Add combined BD tester
    [bd-tester.kicad_pcb, bd-tester.kicad_sch]
2026-03-18 DRC cleanup
    [bd-tester.kicad_pcb]
2026-06-18 Source for bd1-tester board
2026-06-20 Add bd-tester pg v1.0
    [bd-tester-NPTH.drl, bd-tester.drl, bd-tester.gbl, bd-tester.gbo, bd-tester.gbp, bd-tester.gbr, bd-tester.gbs, bd-tester.gm1]
